charitywater/afridev2-sensor/software/firmware/application/src/waterAlgorithm/algo-c-code/README.md

# algo-c-code

Repository for auto generated C code for water and stroke algorithms. 

Pull down the latest generated C code only after review of the changes and coordination with algorithm developers.
