charitywater/afridev2-sensor/hardware/ME Drawings/Afridev_Mechanical_Package_3-21-18/001_Outpour-afridev3/PCBA, afridev2.sldasm

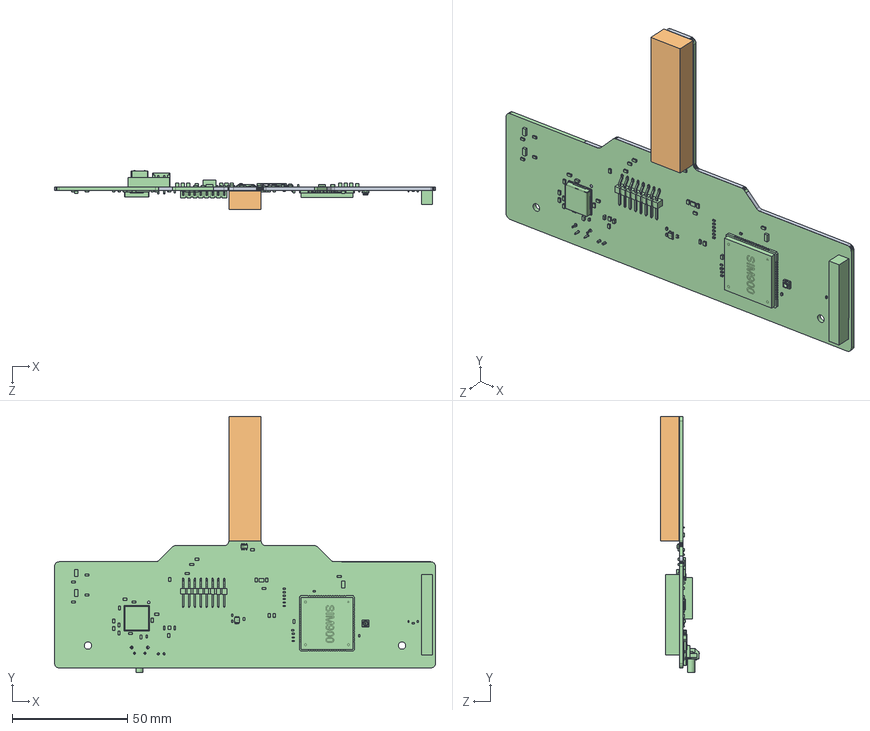
[picture p28: CAD file, 2019-01-26]
hardware/ME Drawings/Afridev_Mechanical_Package_3-21-18/001_Outpour-afridev3/PCBA, afridev2.sldasm
165.0 x 111.1 x 16.7 mm
PCB, afridev2
foam, afridev2 pcba
adhesive, afridev2 pcba
AfriDev_finalPlacement
