charitywater/afridev2-sensor/hardware/ME Drawings/Afridev_Mechanical_Package_3-21-18/001_Outpour-afridev3/01_large_oring.SLDPRT

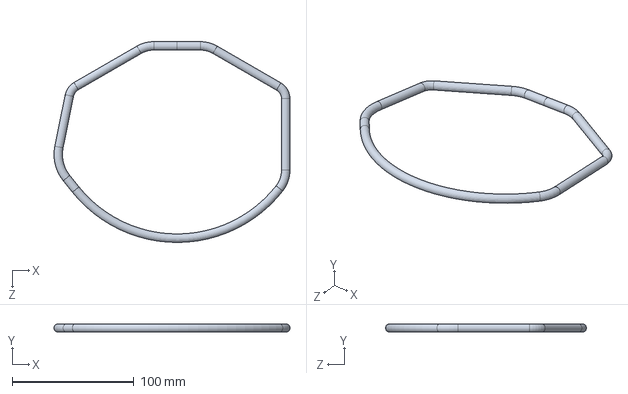
[picture p29: CAD file, 2019-01-26]
hardware/ME Drawings/Afridev_Mechanical_Package_3-21-18/001_Outpour-afridev3/01_large_oring.SLDPRT
194.0 x 6.99 x 165.1 mm
