charitywater/afridev2-sensor/hardware/ME Drawings/Afridev_Mechanical_Package_3-21-18/001_Outpour-afridev3/01_small_oring.SLDPRT

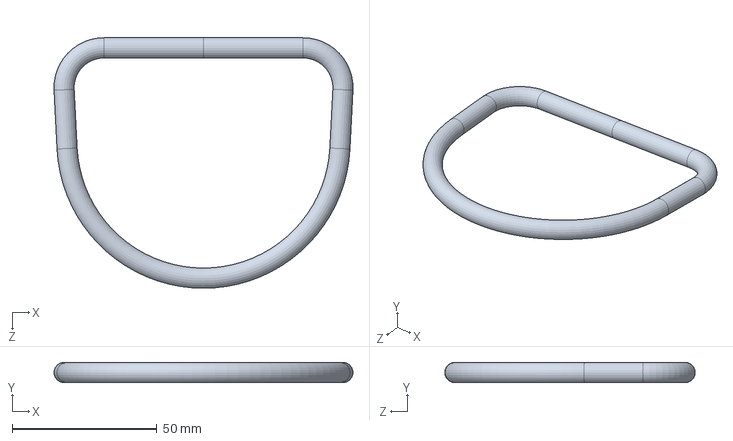
[picture p30: CAD file, 2019-01-26]
hardware/ME Drawings/Afridev_Mechanical_Package_3-21-18/001_Outpour-afridev3/01_small_oring.SLDPRT
103.3 x 6.99 x 86.6 mm
