charitywater/afridev2-sensor/hardware/ME Drawings/Afridev_Mechanical_Package_3-21-18/001_Outpour-afridev3/spacer.SLDPRT

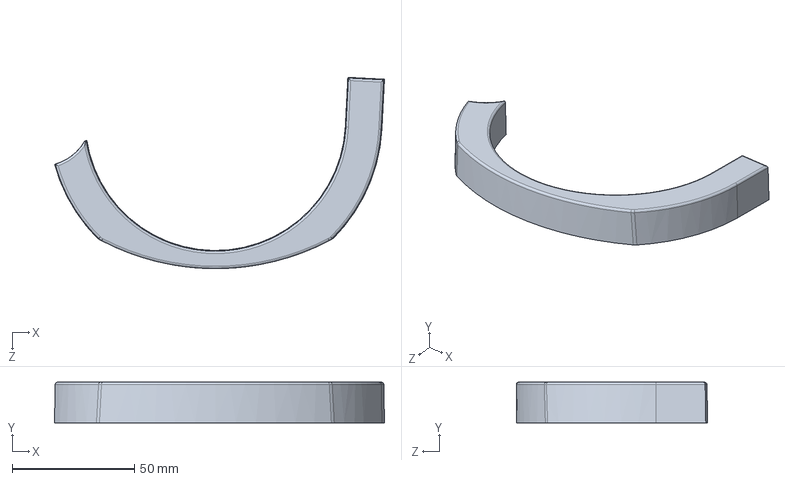
[picture p31: CAD file, 2019-01-26]
hardware/ME Drawings/Afridev_Mechanical_Package_3-21-18/001_Outpour-afridev3/spacer.SLDPRT
134.8 x 16.6 x 78.1 mm
