charitywater/afridev2-sensor/hardware/ME Drawings/Afridev_Mechanical_Package_3-21-18/001_Outpour-afridev3/foam, afridev2 pcba.SLDPRT

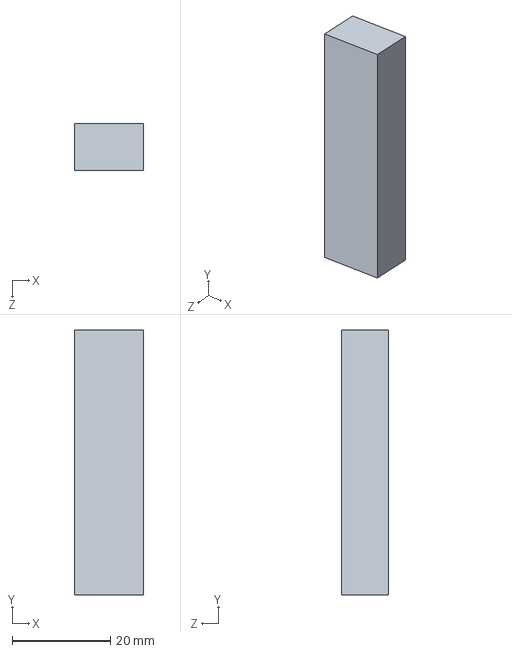
[picture p32: CAD file, 2019-01-26]
hardware/ME Drawings/Afridev_Mechanical_Package_3-21-18/001_Outpour-afridev3/foam, afridev2 pcba.SLDPRT
14.0 x 54.0 x 9.53 mm
