charitywater/afridev2-sensor/hardware/ME Drawings/Afridev_Mechanical_Package_3-21-18/001_Outpour-afridev3/barcode_label.SLDPRT

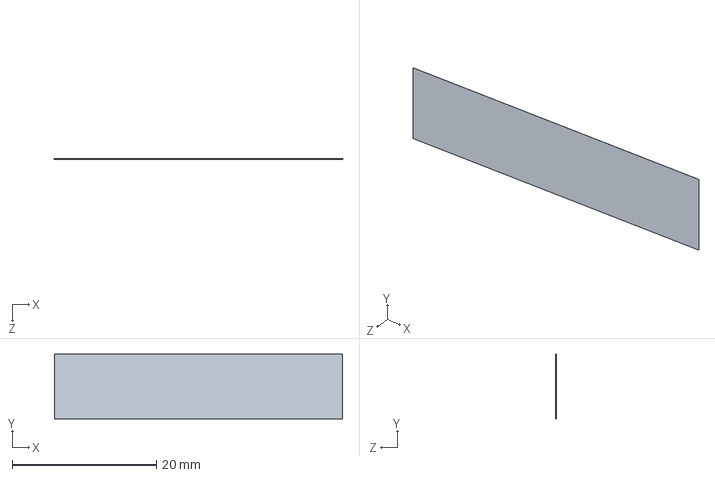
[picture p33: CAD file, 2019-01-26]
hardware/ME Drawings/Afridev_Mechanical_Package_3-21-18/001_Outpour-afridev3/barcode_label.SLDPRT
40.0 x 9.00 x 0.01 mm
