charitywater/afridev2-sensor/hardware/ME Drawings/Afridev_Mechanical_Package_3-21-18/001_Outpour-afridev3/outpour-top-export.sldprt

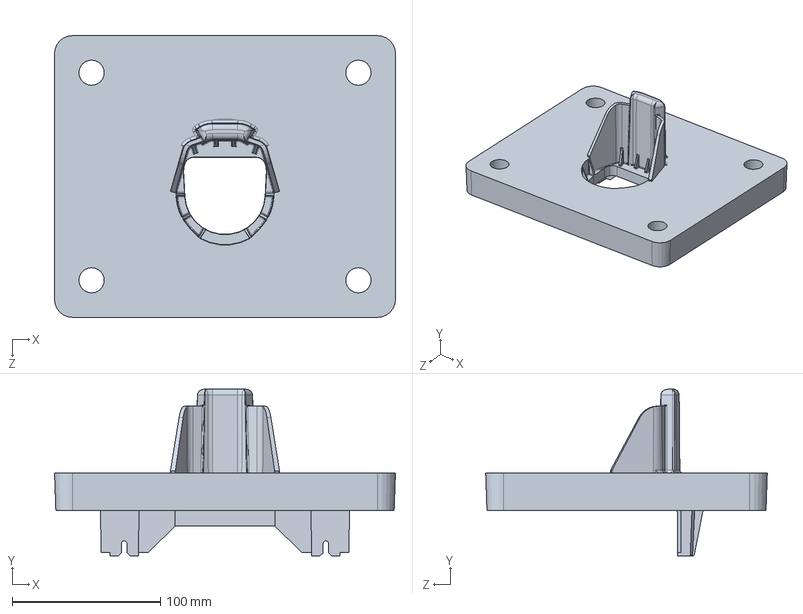
[picture p35: CAD file, 2019-01-26]
hardware/ME Drawings/Afridev_Mechanical_Package_3-21-18/001_Outpour-afridev3/outpour-top-export.sldprt
230.0 x 112.5 x 190.0 mm
