charitywater/afridev2-sensor/hardware/ME Drawings/Afridev_Mechanical_Package_3-21-18/001_Outpour-afridev3/outpour-bottom-export.sldprt

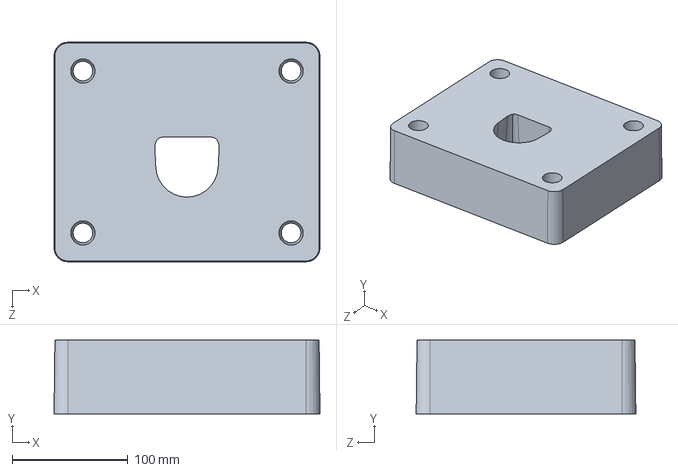
[picture p36: CAD file, 2019-01-26]
hardware/ME Drawings/Afridev_Mechanical_Package_3-21-18/001_Outpour-afridev3/outpour-bottom-export.sldprt
230.0 x 64.0 x 190.0 mm
