charitywater/afridev2-sensor/hardware/ME Drawings/Afridev_Mechanical_Package_3-21-18/001_Outpour-afridev3/01_nutplate_internal.SLDPRT

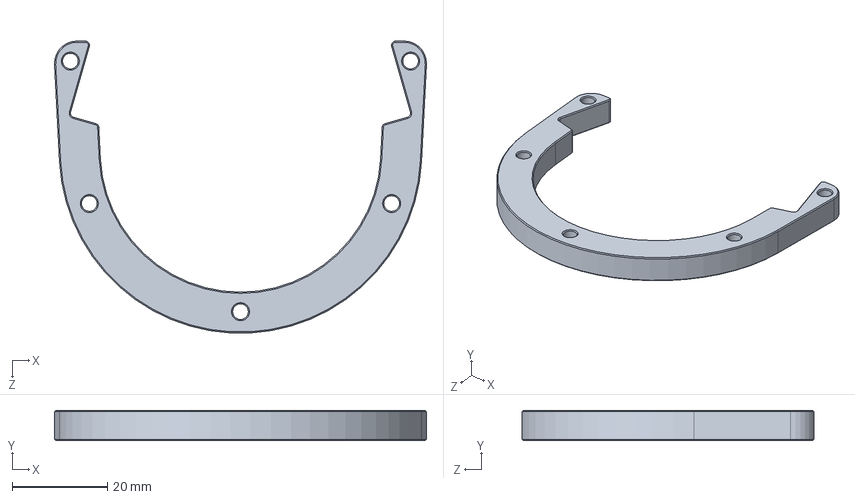
[picture p37: CAD file, 2019-01-26]
hardware/ME Drawings/Afridev_Mechanical_Package_3-21-18/001_Outpour-afridev3/01_nutplate_internal.SLDPRT
78.3 x 6.35 x 61.4 mm
