charitywater/afridev2-sensor/hardware/ME Drawings/Afridev_Mechanical_Package_3-21-18/001_Outpour-afridev3/foam-battery.SLDPRT

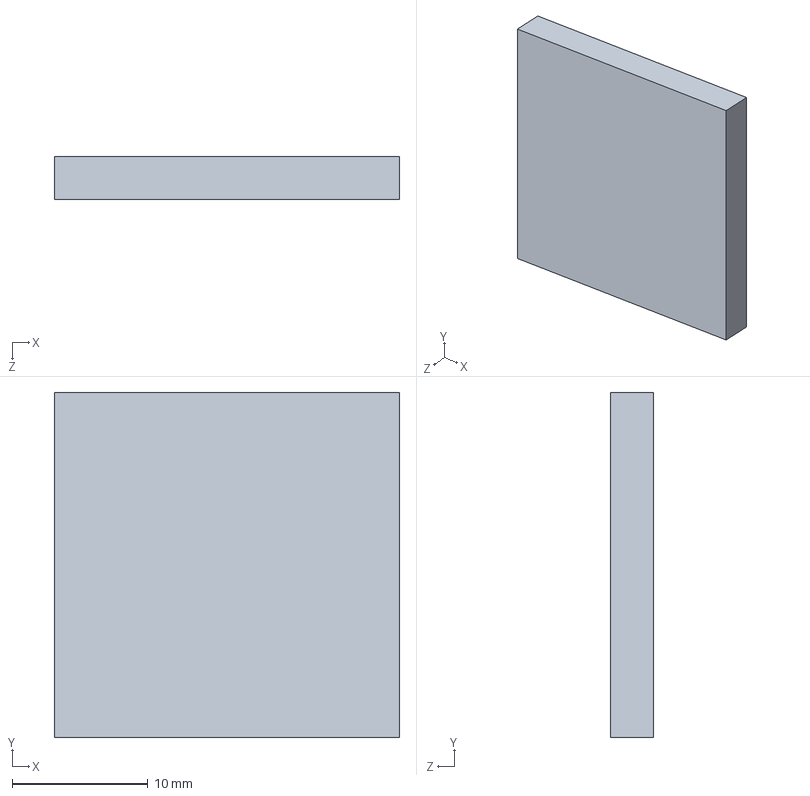
[picture p38: CAD file, 2019-01-26]
hardware/ME Drawings/Afridev_Mechanical_Package_3-21-18/001_Outpour-afridev3/foam-battery.SLDPRT
25.4 x 25.4 x 3.18 mm
