charitywater/afridev2-sensor/hardware/ME Drawings/Afridev_Mechanical_Package_3-21-18/001_Outpour-afridev3/adhesive, afridev2 pcba.SLDPRT

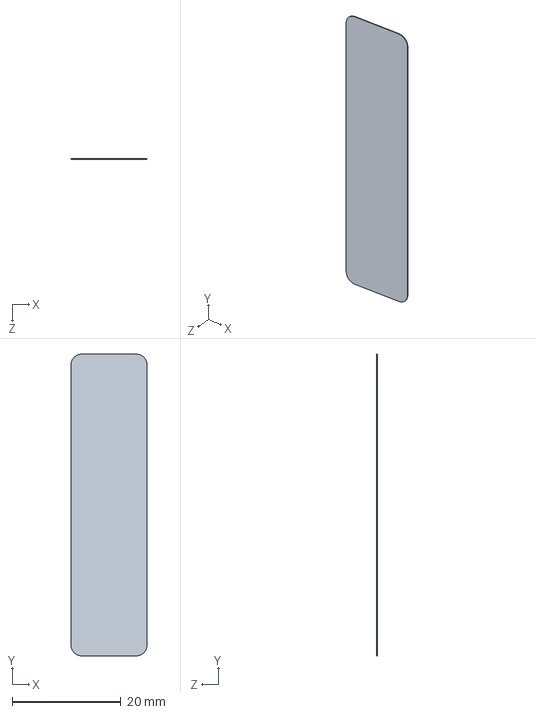
[picture p39: CAD file, 2019-01-26]
hardware/ME Drawings/Afridev_Mechanical_Package_3-21-18/001_Outpour-afridev3/adhesive, afridev2 pcba.SLDPRT
14.0 x 55.5 x 0.127 mm
