charitywater/afridev2-sensor/hardware/ME Drawings/Afridev_Mechanical_Package_3-21-18/001_Outpour-afridev3/PCB, afridev2.SLDPRT

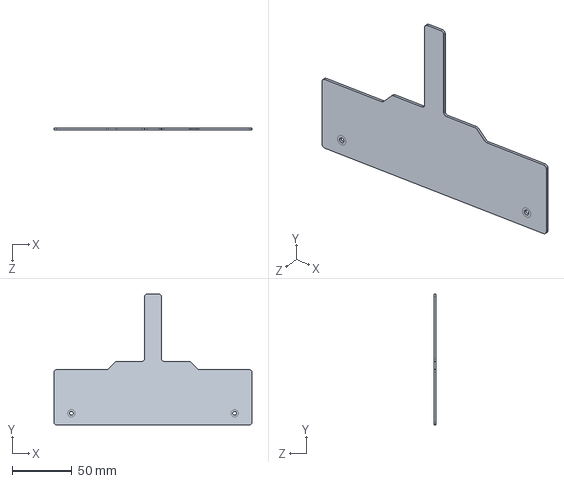
[picture p40: CAD file, 2019-01-26]
hardware/ME Drawings/Afridev_Mechanical_Package_3-21-18/001_Outpour-afridev3/PCB, afridev2.SLDPRT
165.0 x 109.0 x 1.60 mm
