charitywater/afridev2-sensor/hardware/ME Drawings/Afridev_Mechanical_Package_3-21-18/001_Outpour-afridev3/01_hsg_bottom.SLDPRT

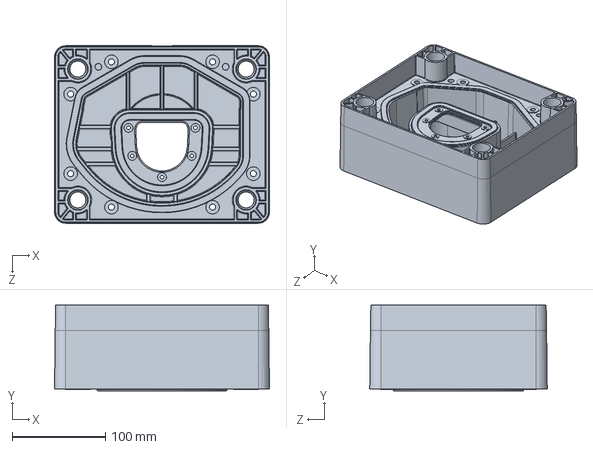
[picture p41: CAD file, 2019-01-26]
hardware/ME Drawings/Afridev_Mechanical_Package_3-21-18/001_Outpour-afridev3/01_hsg_bottom.SLDPRT
230.0 x 91.8 x 190.0 mm
