charitywater/afridev2-sensor/hardware/ME Drawings/Afridev_Mechanical_Package_3-21-18/001_Outpour-afridev3/91287A204_18-8 STAINLESS STEEL HEX HEAD CAP SCREW.SLDPRT

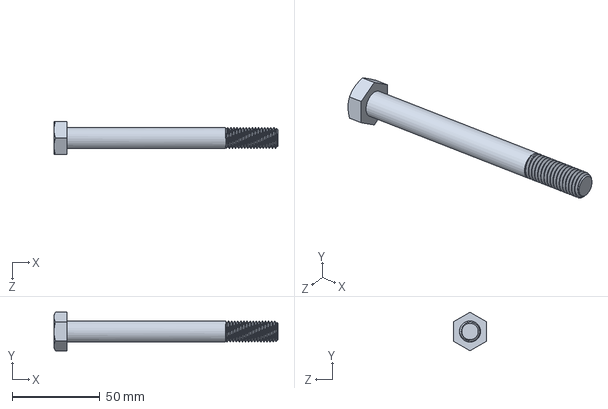
[picture p42: CAD file, 2019-01-26]
hardware/ME Drawings/Afridev_Mechanical_Package_3-21-18/001_Outpour-afridev3/91287A204_18-8 STAINLESS STEEL HEX HEAD CAP SCREW.SLDPRT
127.5 x 21.9 x 19.0 mm
