charitywater/afridev2-sensor/hardware/ME Drawings/Afridev_Mechanical_Package_3-21-18/001_Outpour-afridev3/90965A170_TYPE 316 STAINLESS STEEL FLAT WASHER.SLDPRT

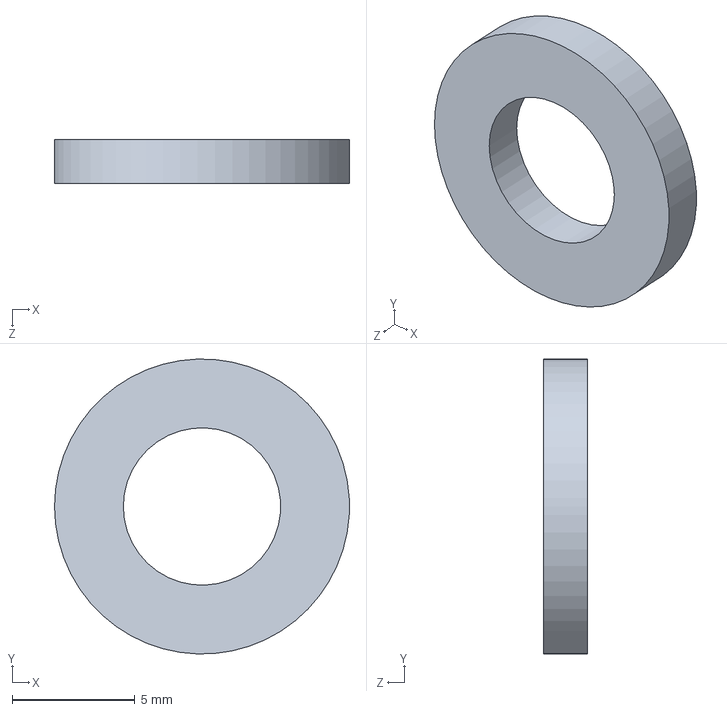
[picture p43: CAD file, 2019-01-26]
hardware/ME Drawings/Afridev_Mechanical_Package_3-21-18/001_Outpour-afridev3/90965A170_TYPE 316 STAINLESS STEEL FLAT WASHER.SLDPRT
12.0 x 12.0 x 1.80 mm
