charitywater/afridev2-sensor/(list of files, cad)

Other CAD files:
hardware/ME Drawings/Afridev_Mechanical_Package_3-21-18/001_Outpour-afridev3/Outpour-Cell-93111.sldprt
hardware/ME Drawings/Afridev_Mechanical_Package_3-21-18/001_Outpour-afridev3/outpour-afridev-outer-o-ring.sldprt
hardware/ME Drawings/Afridev_Mechanical_Package_3-21-18/001_Outpour-afridev3/01_hsg_bottom.SLDDRW
hardware/ME Drawings/Afridev_Mechanical_Package_3-21-18/001_Outpour-afridev3/01_hsg_top.SLDDRW
hardware/ME Drawings/Afridev_Mechanical_Package_3-21-18/001_Outpour-afridev3/01_nutplate_internal.SLDDRW
hardware/ME Drawings/Afridev_Mechanical_Package_3-21-18/001_Outpour-afridev3/90116A155.SLDPRT
hardware/ME Drawings/Afridev_Mechanical_Package_3-21-18/001_Outpour-afridev3/90116A213_METRIC 316 SS PAN HEAD PHILLIPS MACHINE SCREW.SLDPRT
hardware/ME Drawings/Afridev_Mechanical_Package_3-21-18/001_Outpour-afridev3/90116A317_METRIC 316 SS PAN HEAD PHILLIPS MACHINE SCREW.SLDPRT
hardware/ME Drawings/Afridev_Mechanical_Package_3-21-18/001_Outpour-afridev3/92773A104_TYPE 316 SS SERRATED-FLANGE LOCKNUT.SLDPRT
hardware/ME Drawings/Afridev_Mechanical_Package_3-21-18/001_Outpour-afridev3/94205A220_TYPE 316 STAINLESS STEEL NYLON-INSERT LOCKNUT.SLDPRT
hardware/ME Drawings/Afridev_Mechanical_Package_3-21-18/001_Outpour-afridev3/94205A250_TYPE 316 STAINLESS STEEL NYLON-INSERT LOCKNUT.SLDPRT
hardware/ME Drawings/Afridev_Mechanical_Package_3-21-18/001_Outpour-afridev3/Outpour-Cell-93111.SLDDRW
hardware/ME Drawings/Afridev_Mechanical_Package_3-21-18/001_Outpour-afridev3/foam, afridev2 pcba.SLDDRW
hardware/ME Drawings/Afridev_Mechanical_Package_3-21-18/001_Outpour-afridev3/foam-battery.SLDDRW
