charitywater/afridev2-sensor/hardware/ME Drawings/Afridev_Mechanical_Package_3-21-18/01_hsg_bottom-rev3.PDF

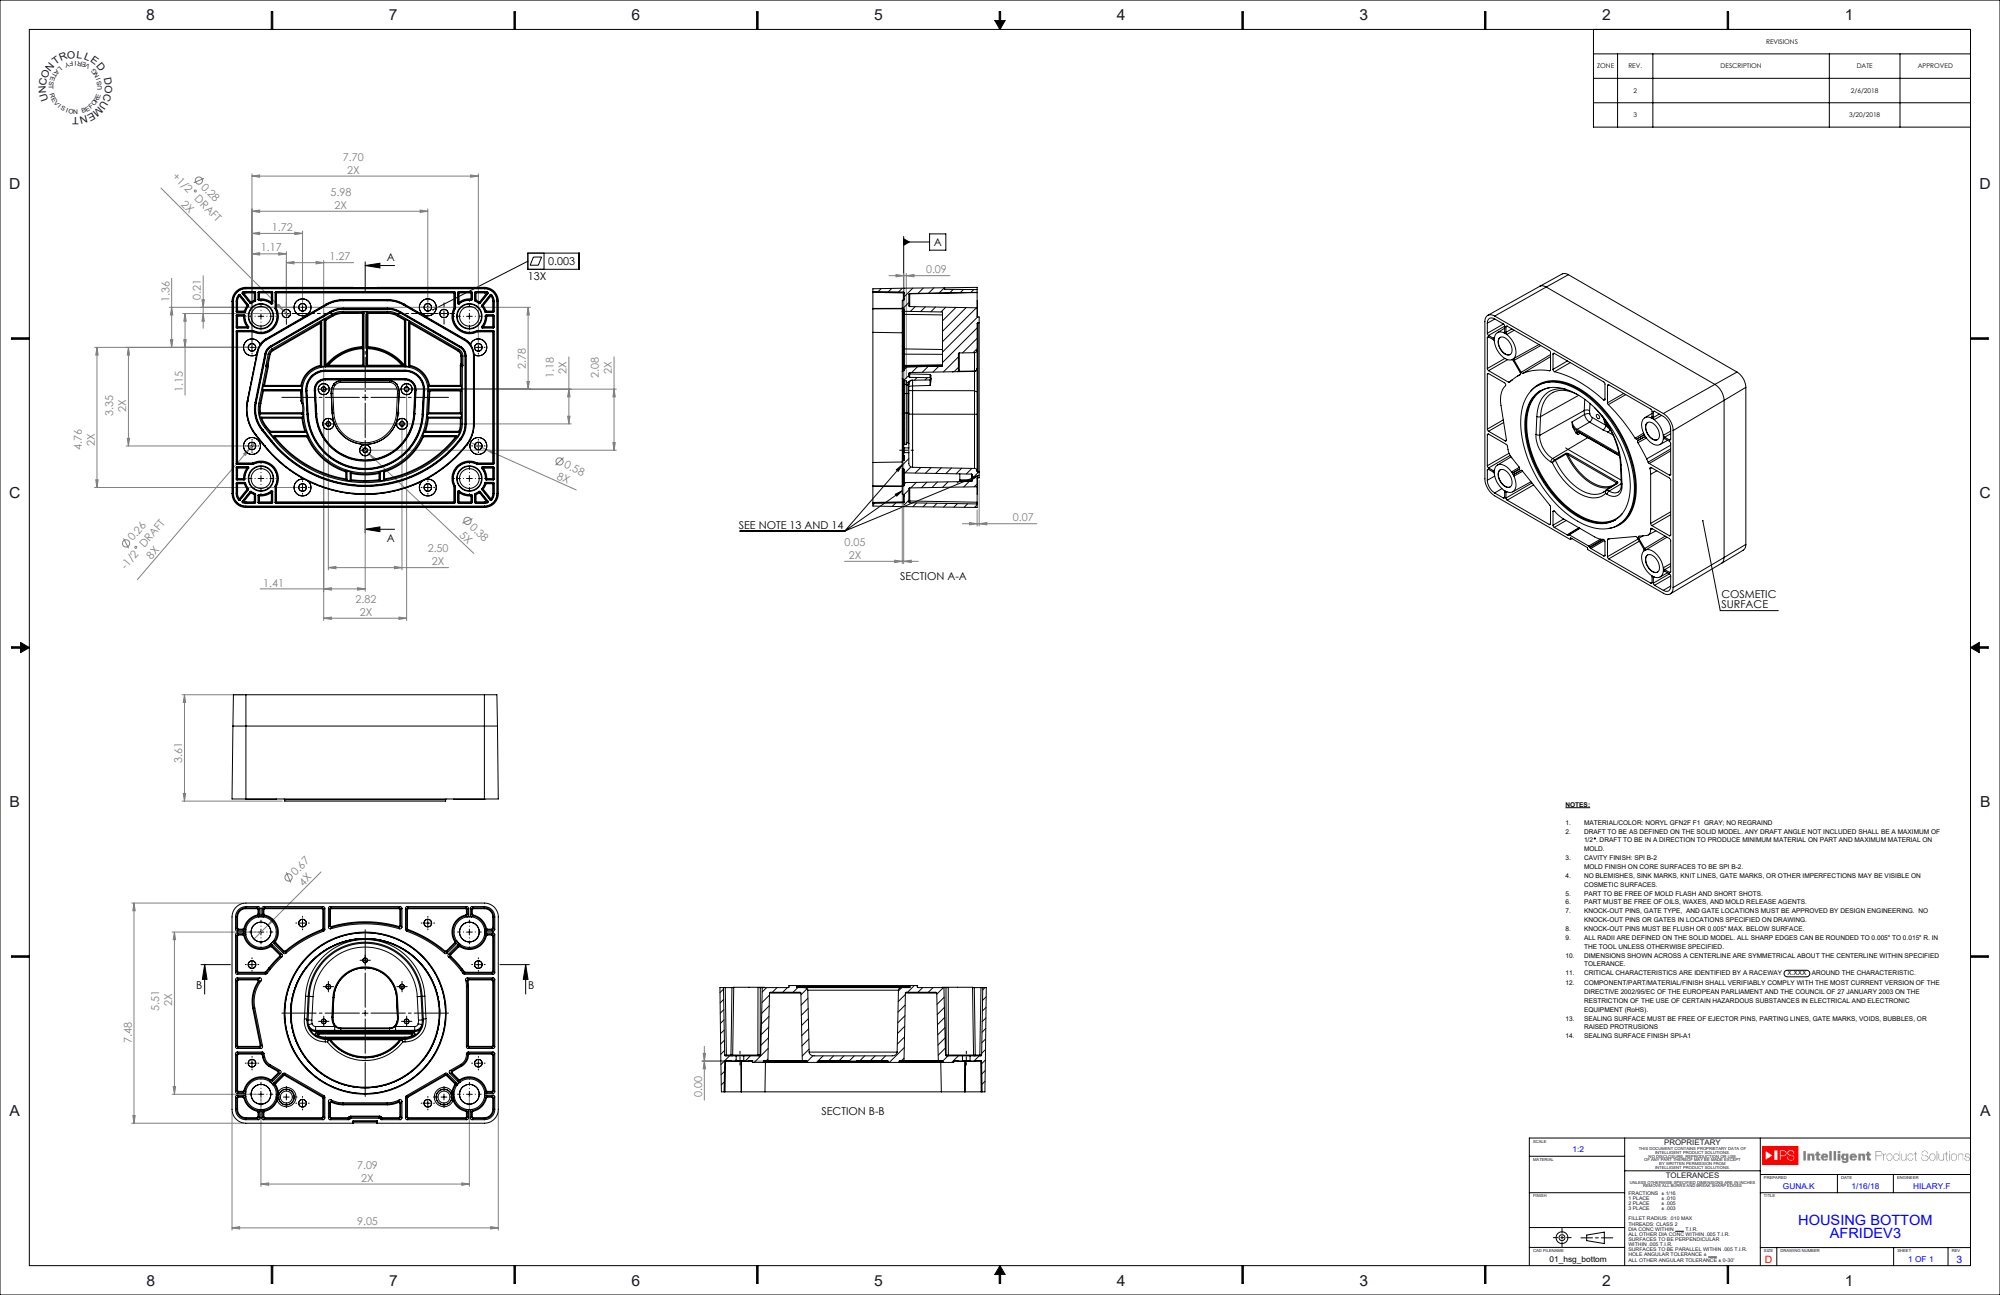
[picture p97: page 1]
+1/2 DRAFT 2X; 0.26 -1/2 DRAFT 8X; SECTION A-A; SECTION B-B; 11. CRITICAL CHARACTERISTICS ARE IDENTIFIED BY A RACEWAY; X.XXX; AROUND THE CHARACTERISTIC.; ZONE; REV.; DESCRIPTION; DATE; APPROVED 2; SIZE D; DRAWING NUMBER; 1 PLACE; 2 PLACE; 3 PLACE; DIA CONC WITHIN; CAD FILENAME; HOUSING BOTTOM

BEFORE US I NG V RE NEMUCOD D LE

SEE NOTE 13 AND 14

1. MATERIAL/COLOR: NORYL GFN2F F1 GRAY; NO REGRAIND
2. DRAFT TO BE AS DEFINED ON THE SOLID MODEL. ANY DRAFT ANGLE NOT INCLUDED SHALL BE A MAXIMUM OF
1/2 . DRAFT TO BE IN A DIRECTION TO PRODUCE MINIMUM MATERIAL ON PART AND MAXIMUM MATERIAL ON
MOLD.
3. CAVITY FINISH: SPI B-2
MOLD FINISH ON CORE SURFACES TO BE SPI B-2.
4. NO BLEMISHES, SINK MARKS, KNIT LINES, GATE MARKS, OR OTHER IMPERFECTIONS MAY BE VISIBLE ON
COSMETIC SURFACES.
5. PART TO BE FREE OF MOLD FLASH AND SHORT SHOTS.
6. PART MUST BE FREE OF OILS, WAXES, AND MOLD RELEASE AGENTS.
7. KNOCK-OUT PINS, GATE TYPE, AND GATE LOCATIONS MUST BE APPROVED BY DESIGN ENGINEERING. NO
KNOCK-OUT PINS OR GATES IN LOCATIONS SPECIFIED ON DRAWING.
8. KNOCK-OUT PINS MUST BE FLUSH OR 0.005" MAX. BELOW SURFACE.
9. ALL RADII ARE DEFINED ON THE SOLID MODEL. ALL SHARP EDGES CAN BE ROUNDED TO 0.005" TO 0.015" R. IN
THE TOOL UNLESS OTHERWISE SPECIFIED.
10. DIMENSIONS SHOWN ACROSS A CENTERLINE ARE SYMMETRICAL ABOUT THE CENTERLINE WITHIN SPECIFIED
TOLERANCE.
12. COMPONENT/PART/MATERIAL/FINISH SHALL VERIFIABLY COMPLY WITH THE MOST CURRENT VERSION OF THE
DIRECTIVE 2002/95/EC OF THE EUROPEAN PARLIAMENT AND THE COUNCIL OF 27 JANUARY 2003 ON THE
RESTRICTION OF THE USE OF CERTAIN HAZARDOUS SUBSTANCES IN ELECTRICAL AND ELECTRONIC
EQUIPMENT (RoHS).
13. SEALING SURFACE MUST BE FREE OF EJECTOR PINS, PARTING LINES, GATE MARKS, VOIDS, BUBBLES, OR
RAISED PROTRUSIONS
14. SEALING SURFACE FINISH SPI-A1

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
