charitywater/afridev2-sensor/hardware/ME Drawings/Afridev_Mechanical_Package_3-21-18/01_nutplate_internal-R1.PDF

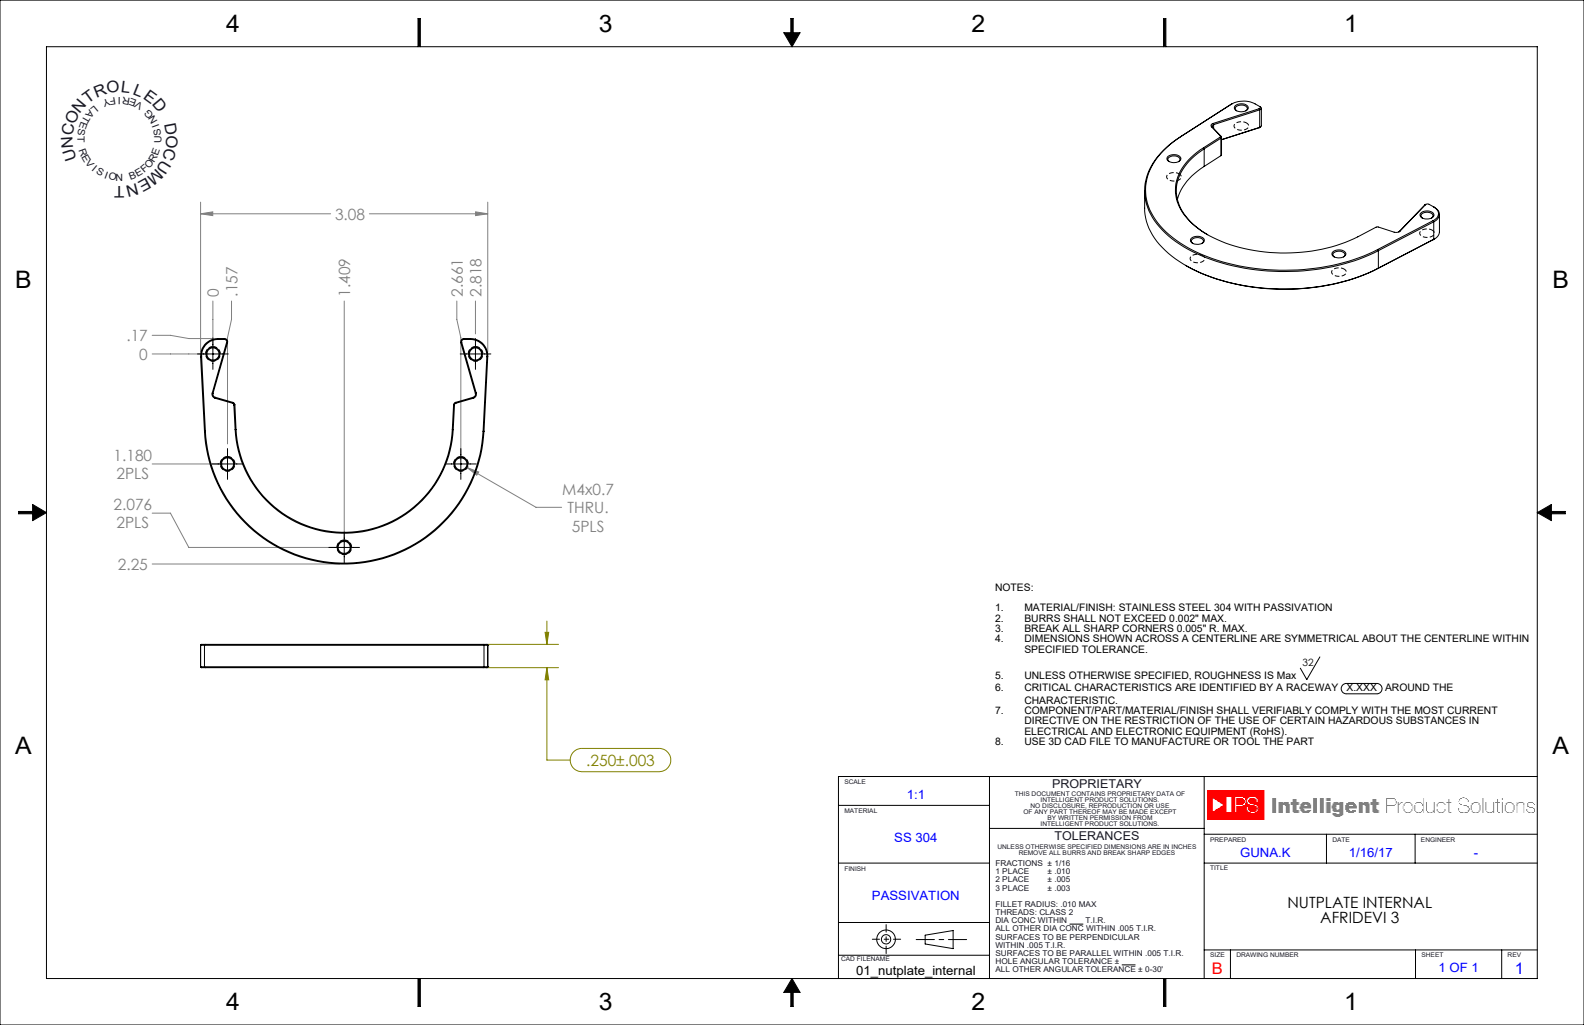
[picture p98: page 1]
CRITICAL CHARACTERISTICS ARE IDENTIFIED BY A RACEWAY; X.XXX; AROUND THE; DRAWING NUMBER; 1 PLACE; 2 PLACE; 3 PLACE; DIA CONC WITHIN; CAD FILENAME; UNLESS OTHERWISE SPECIFIED DIMENSIONS ARE IN INCHES REMOVE ALL BURRS AND BREAK SHARP EDGES; GUNA.K; CONTROL LED; OCUM NE EROF BE; I S VER; SETAL YFI; NUTPLATE INTERNAL AFRIDEVI 3

NOTES:
1. MATERIAL/FINISH: STAINLESS STEEL 304 WITH PASSIVATION
2. BURRS SHALL NOT EXCEED 0.002" MAX.
3. BREAK ALL SHARP CORNERS 0.005" R. MAX.
4. DIMENSIONS SHOWN ACROSS A CENTERLINE ARE SYMMETRICAL ABOUT THE CENTERLINE WITHIN
SPECIFIED TOLERANCE.
UNLESS OTHERWISE SPECIFIED, ROUGHNESS IS Max
CHARACTERISTIC.
7. COMPONENT/PART/MATERIAL/FINISH SHALL VERIFIABLY COMPLY WITH THE MOST CURRENT
DIRECTIVE ON THE RESTRICTION OF THE USE OF CERTAIN HAZARDOUS SUBSTANCES IN
ELECTRICAL AND ELECTRONIC EQUIPMENT (RoHS).
8. USE 3D CAD FILE TO MANUFACTURE OR TOOL THE PART

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
