charitywater/afridev2-sensor/hardware/ME Drawings/Afridev_Mechanical_Package_3-21-18/foam, afridev2 pcba-REV2.PDF

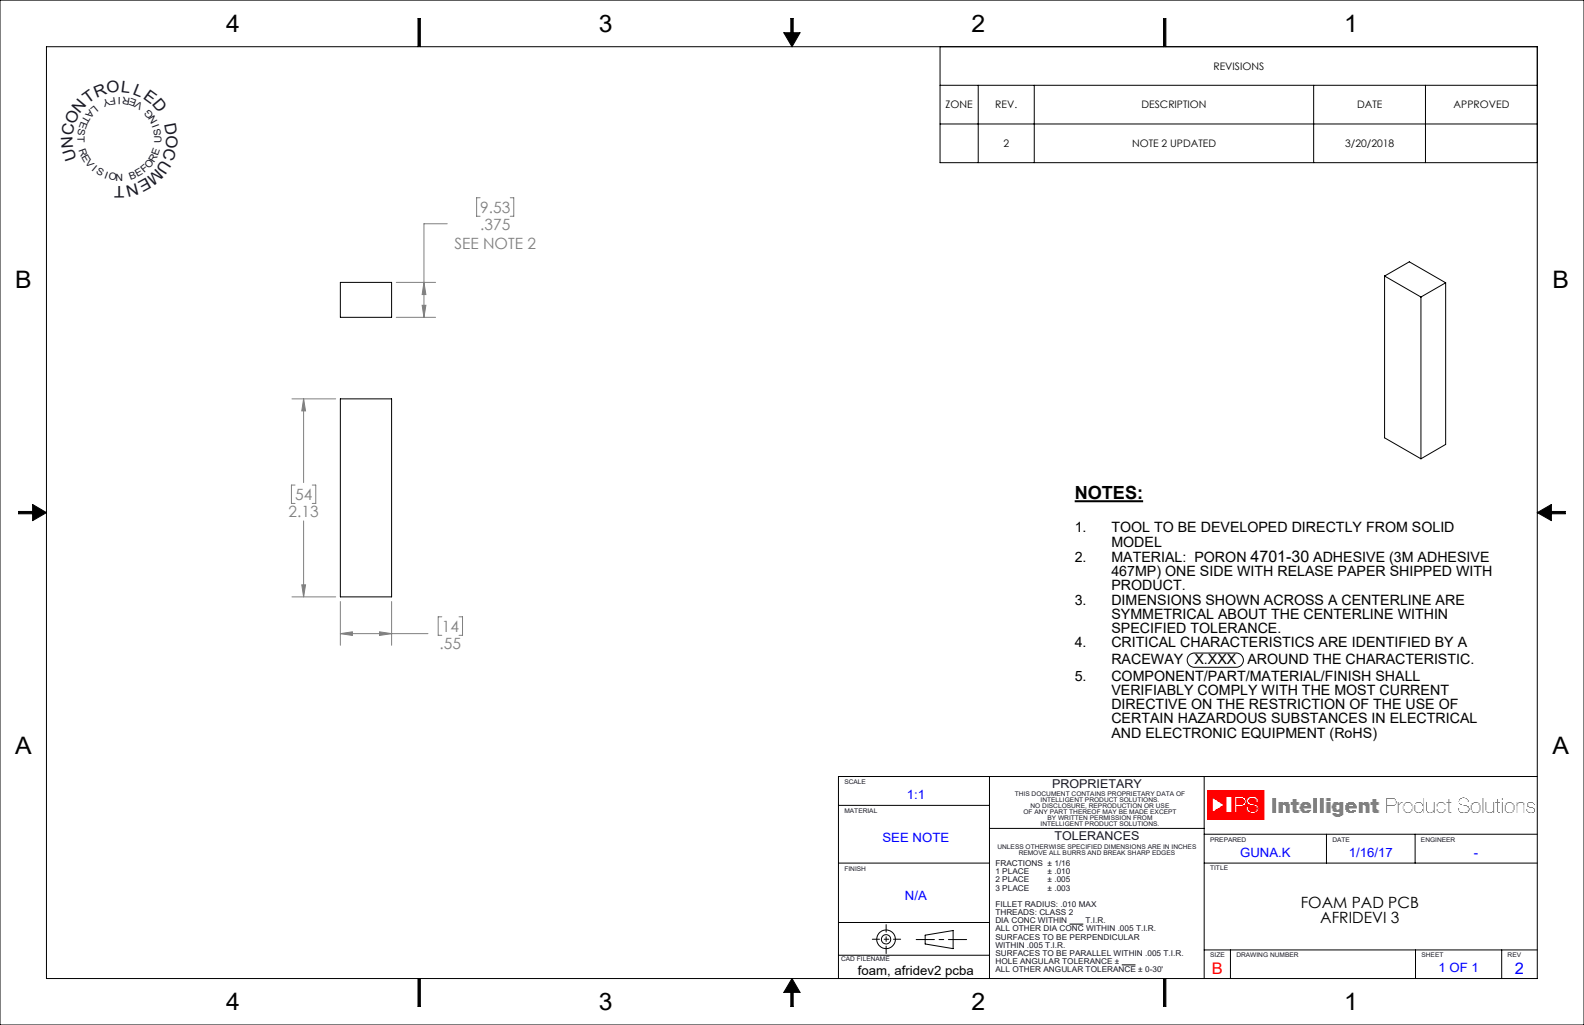
[picture p99: page 1]
SEE NOTE 2; RACEWAY; X.XXX; AROUND THE CHARACTERISTIC.; DRAWING NUMBER; 1 PLACE; 2 PLACE; 3 PLACE; DIA CONC WITHIN; CAD FILENAME; UNLESS OTHERWISE SPECIFIED DIMENSIONS ARE IN INCHES REMOVE ALL BURRS AND BREAK SHARP EDGES; GUNA.K; SEE NOTE; foam, afridev2 pcba; CONTROL LED; OCUM NE EROF BE; I S VER; SETAL YFI

ZONE | REV. | DESCRIPTION | DATE | APPROVED

2 | NOTE 2 UPDATED | 3/20/2018

1. TOOL TO BE DEVELOPED DIRECTLY FROM SOLID
MODEL
2. MATERIAL: PORON 4701-30 ADHESIVE (3M ADHESIVE
467MP) ONE SIDE WITH RELASE PAPER SHIPPED WITH
PRODUCT.
3. DIMENSIONS SHOWN ACROSS A CENTERLINE ARE
SYMMETRICAL ABOUT THE CENTERLINE WITHIN
SPECIFIED TOLERANCE.
4. CRITICAL CHARACTERISTICS ARE IDENTIFIED BY A
5. COMPONENT/PART/MATERIAL/FINISH SHALL
VERIFIABLY COMPLY WITH THE MOST CURRENT
DIRECTIVE ON THE RESTRICTION OF THE USE OF
CERTAIN HAZARDOUS SUBSTANCES IN ELECTRICAL
AND ELECTRONIC EQUIPMENT (RoHS)

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

FOAM PAD PCB
AFRIDEVI 3
