charitywater/afridev2-sensor/hardware/ME Drawings/PDF DRAWING CHARITY WATER REV-1/001_Outpour-afridev3-R1.PDF

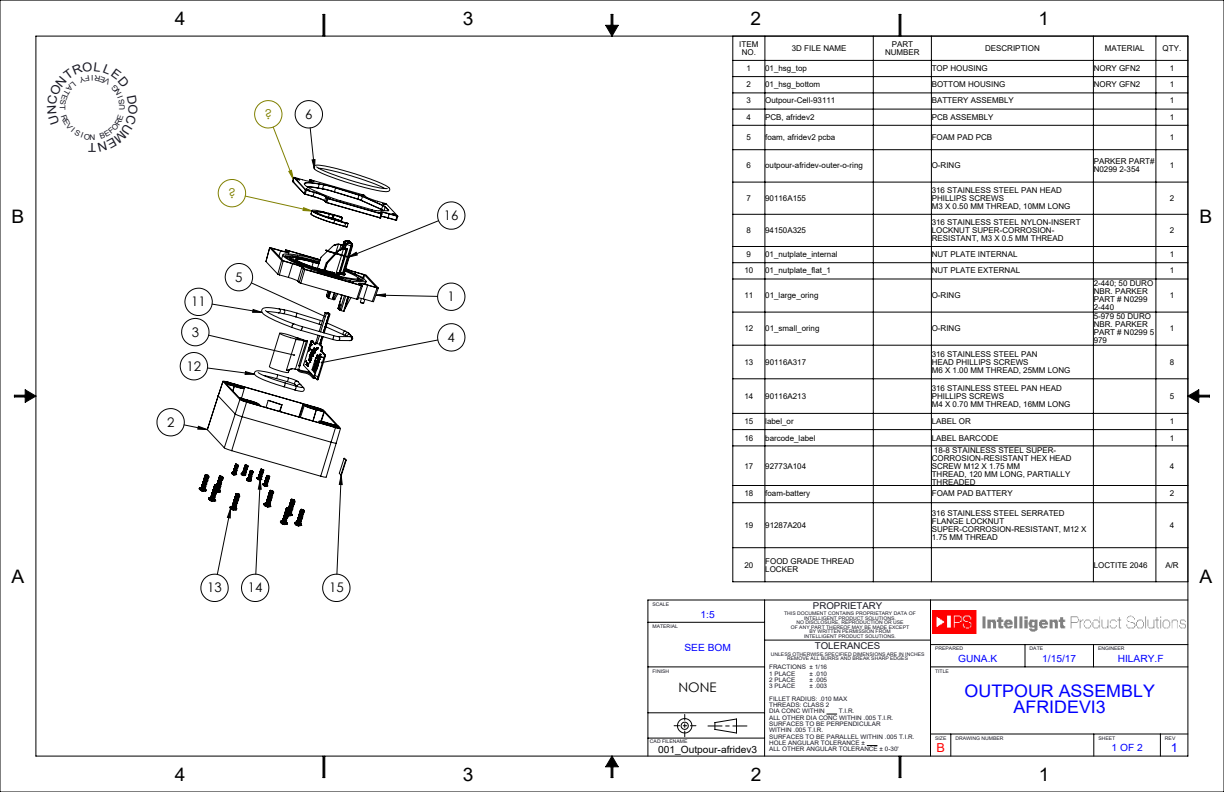
[picture p100: page 1]
SIZE B; DRAWING NUMBER; 1 PLACE; 2 PLACE; 3 PLACE; DIA CONC WITHIN; CAD FILENAME; OUTPOUR ASSEMBLY; SEE BOM

ITEM NO. | 3D FILE NAME | PART NUMBER | DESCRIPTION | MATERIAL | QTY.

LED DOCUM NE REV GNI SU EROF BE

1 | 01_hsg_top | | TOP HOUSING | NORY GFN2 | 1
2 | 01_hsg_bottom | | BOTTOM HOUSING | NORY GFN2 | 1
3 | Outpour-Cell-93111 | | BATTERY ASSEMBLY | | 1
4 | PCB, afridev2 | | PCB ASSEMBLY | | 1
5 | foam, afridev2 pcba | | FOAM PAD PCB | | 1

I S VER TSETAL YF

6 | outpour-afridev-outer-o-ring | | O-RING | PARKER PART# N0299 2-354 | 1

7 | 90116A155 | | 316 STAINLESS STEEL PAN HEAD PHILLIPS SCREWS M3 X 0.50 MM THREAD, 10MM LONG | | 2

8 | 94150A325 | | 316 STAINLESS STEEL NYLON-INSERT LOCKNUT SUPER-CORROSION-RESISTANT, M3 X 0.5 MM THREAD | | 2

9 | 01_nutplate_internal | | NUT PLATE INTERNAL | | 1
10 | 01_nutplate_flat_1 | | NUT PLATE EXTERNAL | | 1
11 | 01_large_oring | | O-RING | 2-440; 50 DURO NBR. PARKER PART # N0299 2-440 | 1

12 | 01_small_oring | | O-RING | 5-979 50 DURO NBR. PARKER PART # N0299 5 979 | 1

13 | 90116A317 | | 316 STAINLESS STEEL PAN HEAD PHILLIPS SCREWS M6 X 1.00 MM THREAD, 25MM LONG | | 8

14 | 90116A213 | | 316 STAINLESS STEEL PAN HEAD PHILLIPS SCREWS M4 X 0.70 MM THREAD, 16MM LONG | | 5

15 | label_or | | LABEL OR | | 1
16 | barcode_label | | LABEL BARCODE | | 1
17 | 92773A104 | | 18-8 STAINLESS STEEL SUPER-CORROSION-RESISTANT HEX HEAD SCREW M12 X 1.75 MM THREAD, 120 MM LONG, PARTIALLY THREADED | | 4

18 | foam-battery | | FOAM PAD BATTERY | | 2
19 | 91287A204 | | 316 STAINLESS STEEL SERRATED FLANGE LOCKNUT SUPER-CORROSION-RESISTANT, M12 X 1.75 MM THREAD | | 4

20 | FOOD GRADE THREAD LOCKER | | | LOCTITE 2046 | A/R

PROPRIETARY THIS DOCUMENT CONTAINS PROPRIETARY DATA OF INTELLIGENT PRODUCT SOLUTIONS. NO DISCLOSURE, REPRODUCTION OR USE OF ANY PART THEREOF MAY BE MADE EXCEPT BY WRITTEN PERMISSION FROM INTELLIGENT PRODUCT SOLUTIONS.

UNLESS OTHERWISE SPECIFIED DIMENSIONS ARE IN INCHES REMOVE ALL BURRS AND BREAK SHARP EDGES
FRACTIONS ± 1/16
FILLET RADIUS: .010 MAX
THREADS: CLASS 2
ALL OTHER DIA CONC WITHIN .005 T.I.R.
SURFACES TO BE PERPENDICULAR
WITHIN .005 T.I.R.
SURFACES TO BE PARALLEL WITHIN .005 T.I.R.
HOLE ANGULAR TOLERANCE ±
ALL OTHER ANGULAR TOLERANCE ± 0-30'

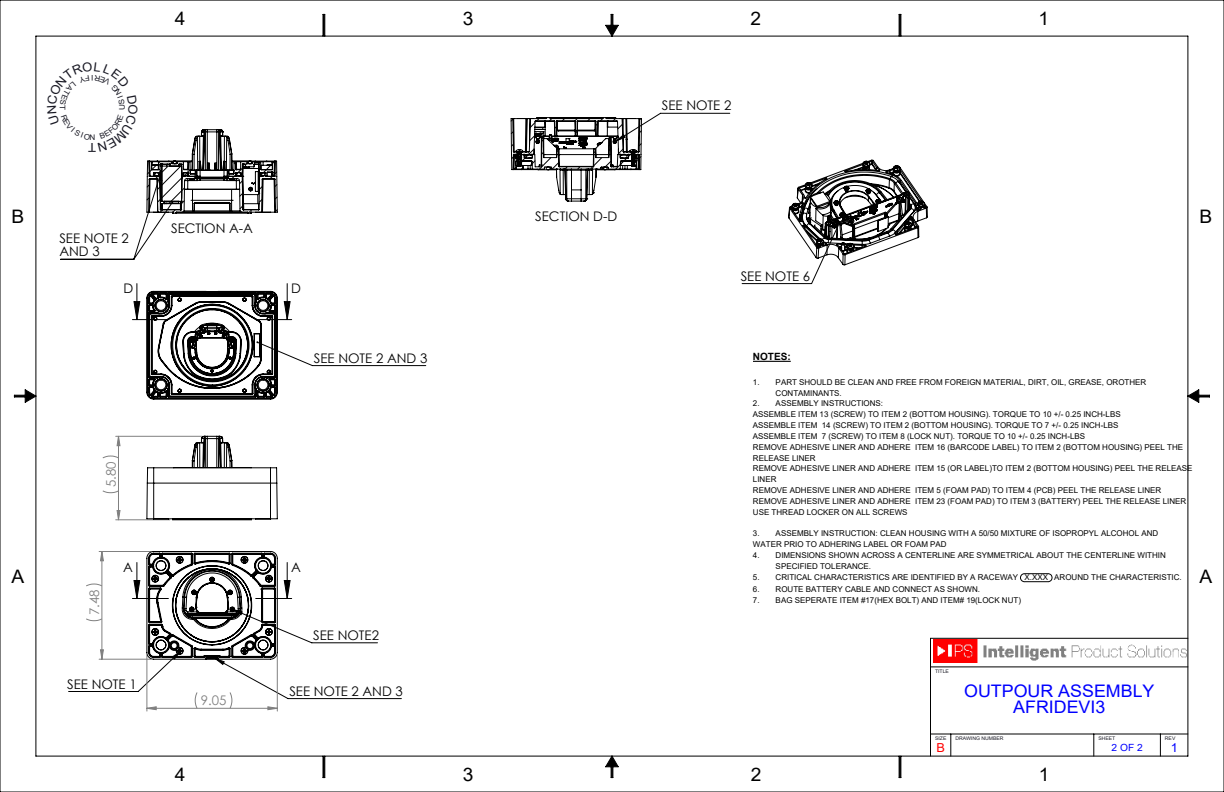
[picture p101: page 2]
SEE NOTE 1; SEE NOTE2; SECTION A-A; SEE NOTE 2 AND 3; SECTION D-D; SEE NOTE 2; SEE NOTE 6; CRITICAL CHARACTERISTICS ARE IDENTIFIED BY A RACEWAY; X.XXX; AROUND THE CHARACTERISTIC.; DRAWING NUMBER; OUTPOUR ASSEMBLY; CONTROL LED; OCUM NE EROF BE; I S VER; SETAL YFI

SEE NOTE 2 AND 3

1. PART SHOULD BE CLEAN AND FREE FROM FOREIGN MATERIAL, DIRT, OIL, GREASE, OROTHER
CONTAMINANTS.
2. ASSEMBLY INSTRUCTIONS:
ASSEMBLE ITEM 13 (SCREW) TO ITEM 2 (BOTTOM HOUSING). TORQUE TO 10 +/- 0.25 INCH-LBS
ASSEMBLE ITEM 14 (SCREW) TO ITEM 2 (BOTTOM HOUSING). TORQUE TO 7 +/- 0.25 INCH-LBS
ASSEMBLE ITEM 7 (SCREW) TO ITEM 8 (LOCK NUT). TORQUE TO 10 +/- 0.25 INCH-LBS
REMOVE ADHESIVE LINER AND ADHERE ITEM 16 (BARCODE LABEL) TO ITEM 2 (BOTTOM HOUSING) PEEL THE
RELEASE LINER
REMOVE ADHESIVE LINER AND ADHERE ITEM 15 (OR LABEL)TO ITEM 2 (BOTTOM HOUSING) PEEL THE RELEASE
LINER
REMOVE ADHESIVE LINER AND ADHERE ITEM 5 (FOAM PAD) TO ITEM 4 (PCB) PEEL THE RELEASE LINER
REMOVE ADHESIVE LINER AND ADHERE ITEM 23 (FOAM PAD) TO ITEM 3 (BATTERY) PEEL THE RELEASE LINER
USE THREAD LOCKER ON ALL SCREWS

3. ASSEMBLY INSTRUCTION: CLEAN HOUSING WITH A 50/50 MIXTURE OF ISOPROPYL ALCOHOL AND
WATER PRIO TO ADHERING LABEL OR FOAM PAD
4. DIMENSIONS SHOWN ACROSS A CENTERLINE ARE SYMMETRICAL ABOUT THE CENTERLINE WITHIN
SPECIFIED TOLERANCE.
6. ROUTE BATTERY CABLE AND CONNECT AS SHOWN.
7. BAG SEPERATE ITEM #17(HEX BOLT) AND ITEM# 19(LOCK NUT)
