charitywater/afridev2-sensor/hardware/ME Drawings/PDF DRAWING CHARITY WATER REV-1/Outpour-Cell-93111-R1.PDF

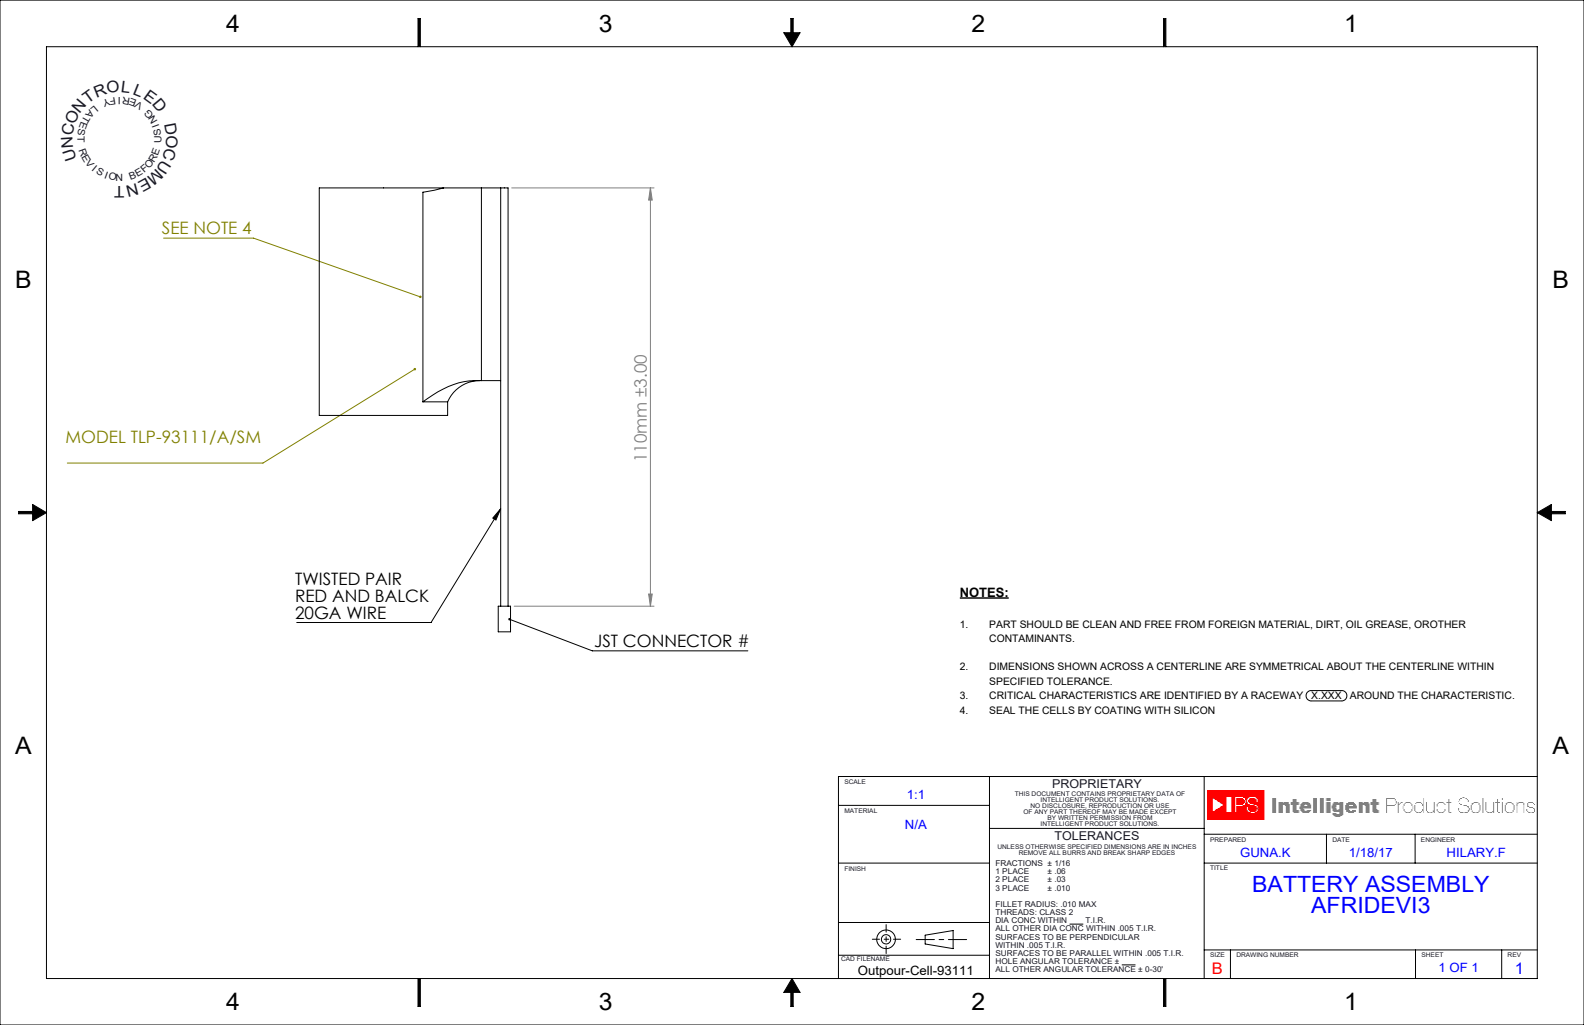
[picture p102: page 1]
JST CONNECTOR #; SEE NOTE 4; CRITICAL CHARACTERISTICS ARE IDENTIFIED BY A RACEWAY; X.XXX; AROUND THE CHARACTERISTIC.; DRAWING NUMBER; 1 PLACE; 2 PLACE; 3 PLACE; DIA CONC WITHIN; CAD FILENAME; BATTERY ASSEMBLY; CONTROL LED; OCUM NE EROF BE; I S VER; SETAL YFI

MODEL TLP-93111/A/SM

TWISTED PAIR
RED AND BALCK
20GA WIRE

1. PART SHOULD BE CLEAN AND FREE FROM FOREIGN MATERIAL, DIRT, OIL GREASE, OROTHER
CONTAMINANTS.

2. DIMENSIONS SHOWN ACROSS A CENTERLINE ARE SYMMETRICAL ABOUT THE CENTERLINE WITHIN
SPECIFIED TOLERANCE.
4. SEAL THE CELLS BY COATING WITH SILICON

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
