charitywater/afridev2-sensor/hardware/EE Drawings/Afridev_rev2_ProductionFiles_013018/Schematics/AfriDev_Rev2.0_Schematics.PDF

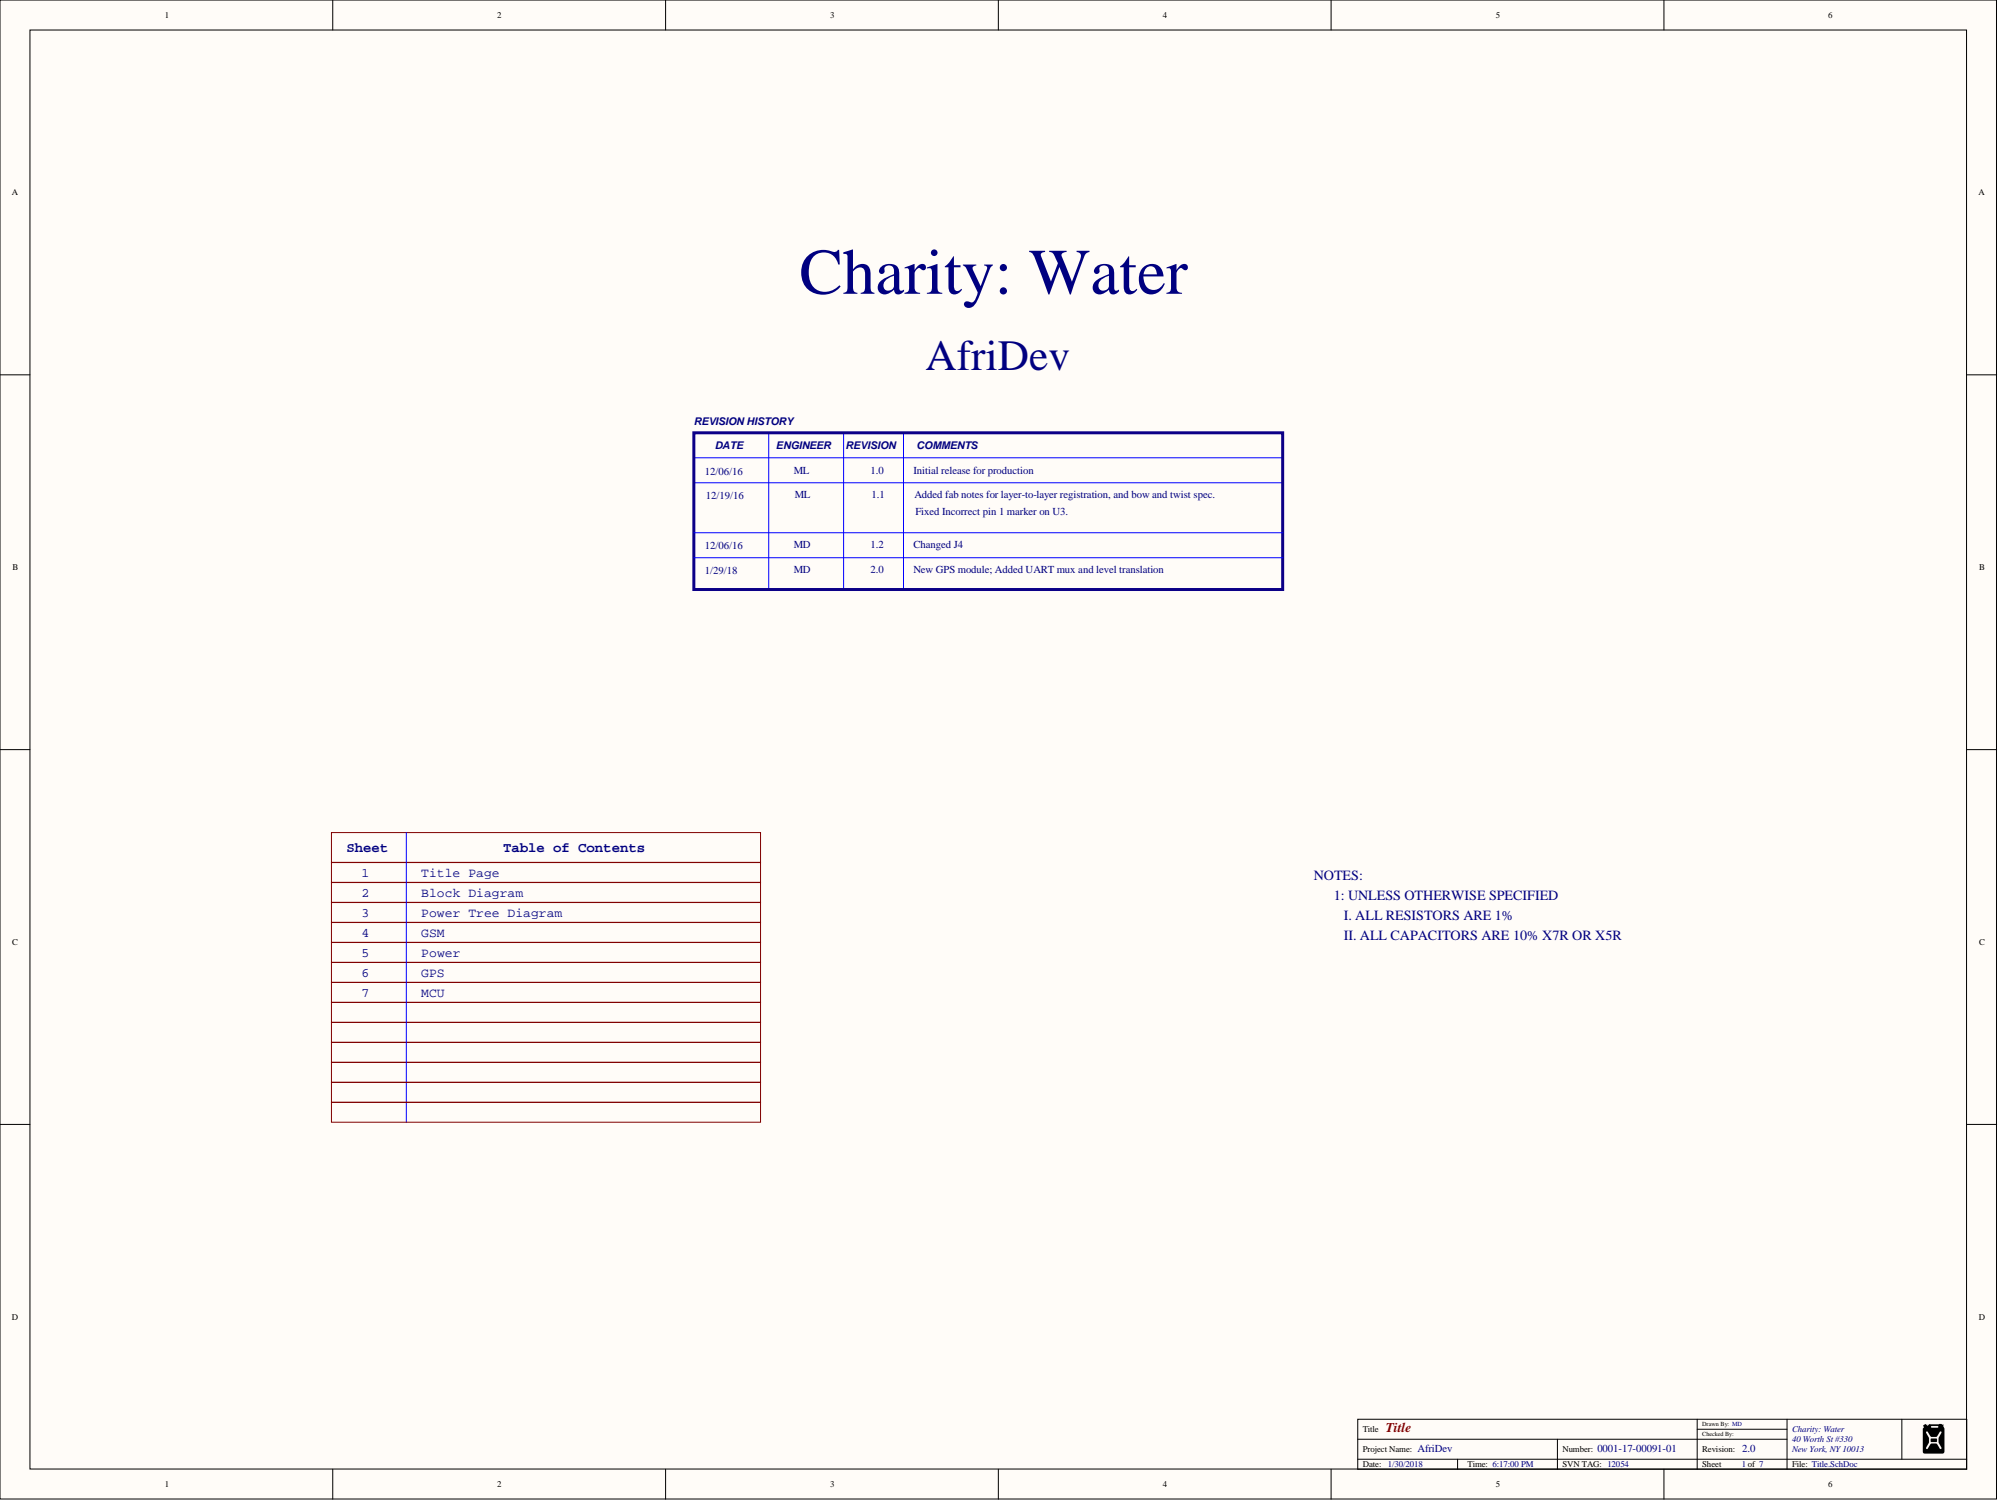
[picture p103: page 1]

DATE | ENGINEER | REVISION | COMMENTS

12/06/16 | ML | 1.0 | Initial release for production

12/19/16 | ML | 1.1 | Added fab notes for layer-to-layer registration, and bow and twist spec. Fixed Incorrect pin 1 marker on U3.

12/06/16 | MD | 1.2 | Changed J4

1/29/18 | MD | 2.0 | New GPS module; Added UART mux and level translation

Sheet | Table of Contents

1 | Title Page

NOTES:
1: UNLESS OTHERWISE SPECIFIED
I. ALL RESISTORS ARE 1%
II. ALL CAPACITORS ARE 10% X7R OR X5R

2 | Block Diagram

3 | Power Tree Diagram

4 | GSM

5 | Power

6 | GPS

7 | MCU

AfriDev Project Name: | 0001-17-00091-01 Number: | 2.0 Revision:

Date: 1/30/2018 | Time: 6:17:00 PM | SVN TAG: 12054 | Sheet of | File: Title.SchDoc

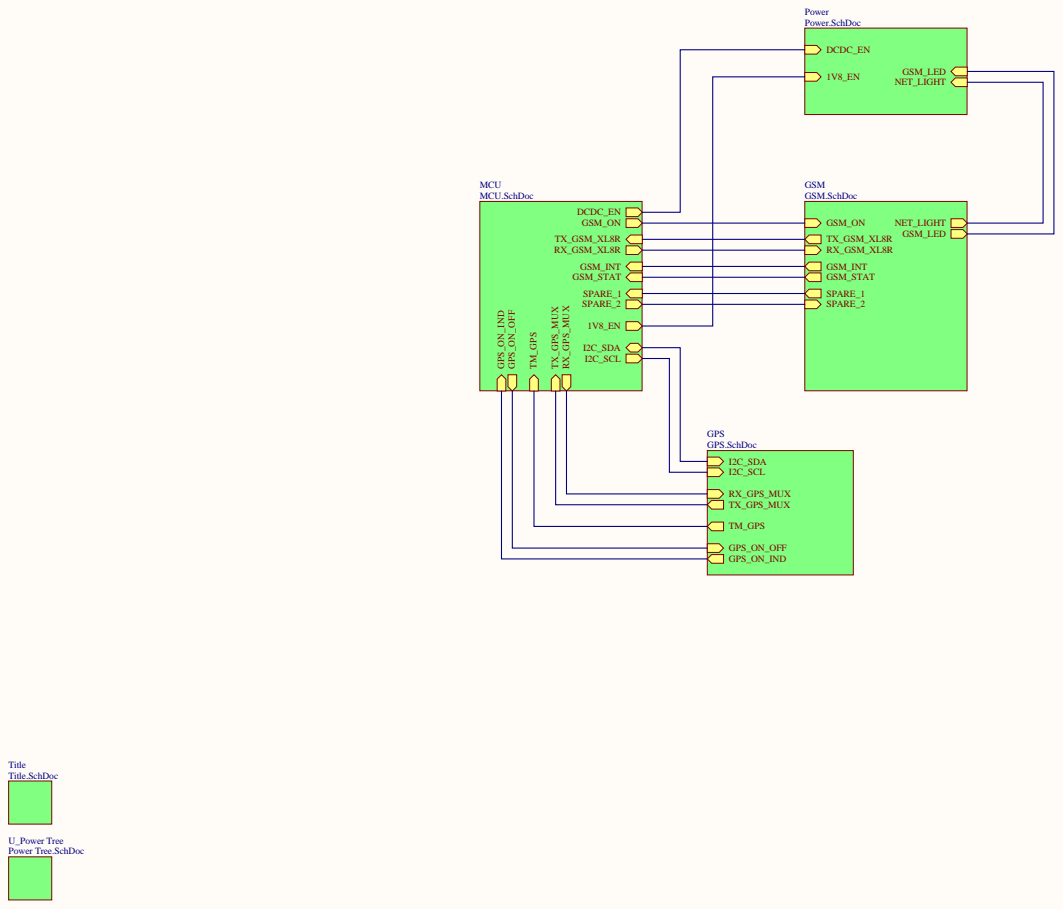
[picture p104: page 2]

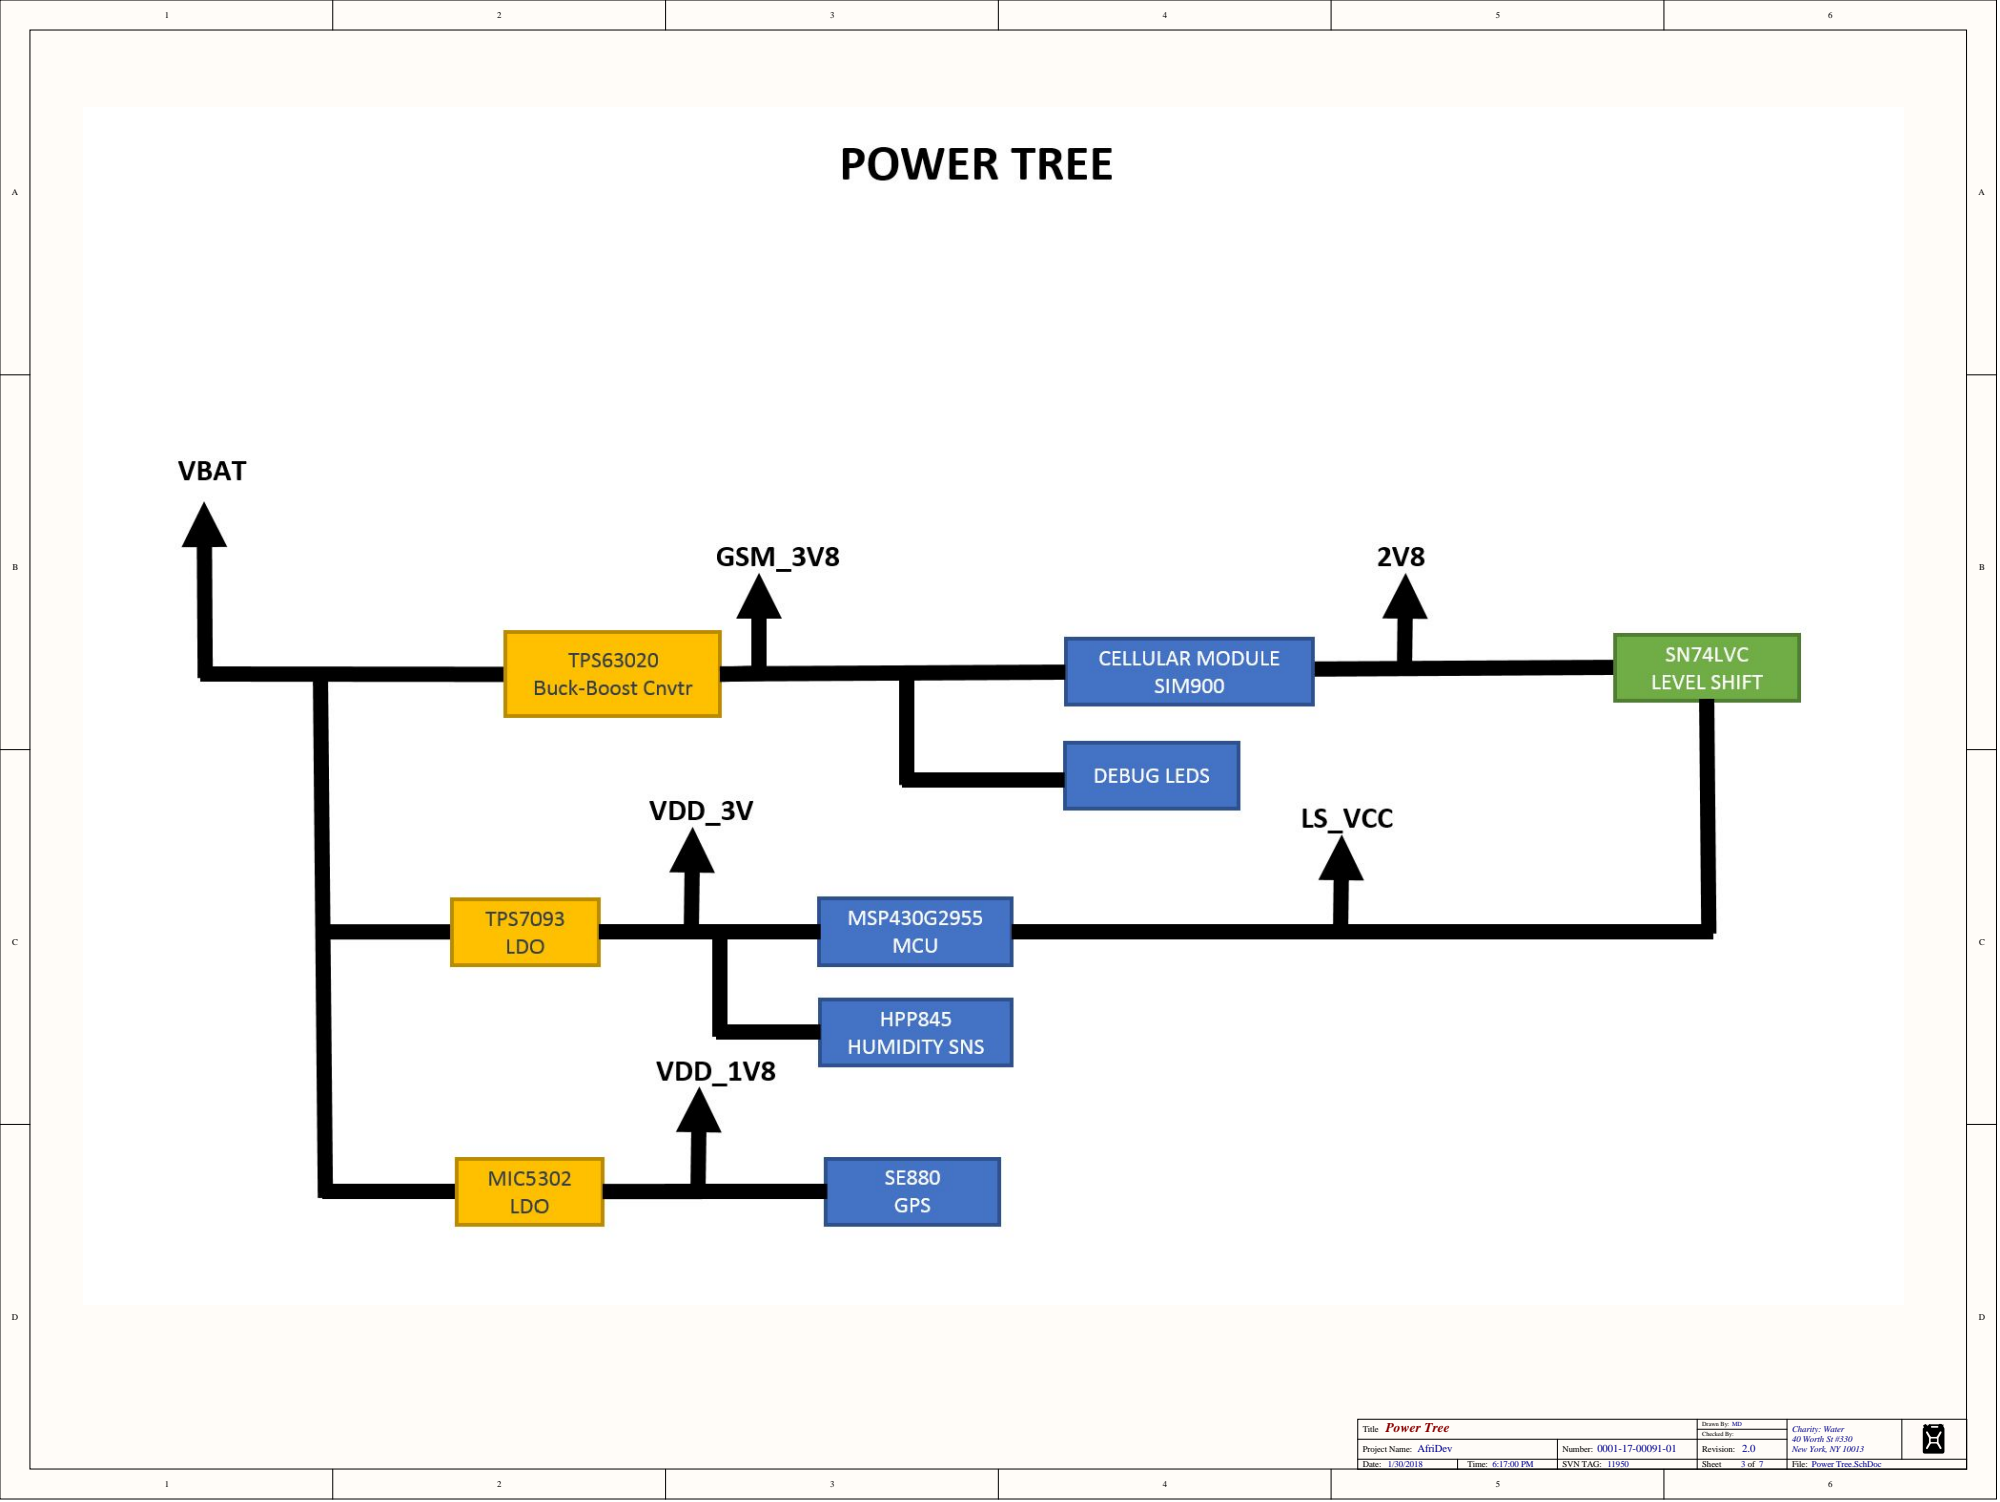
[picture p105: page 3]

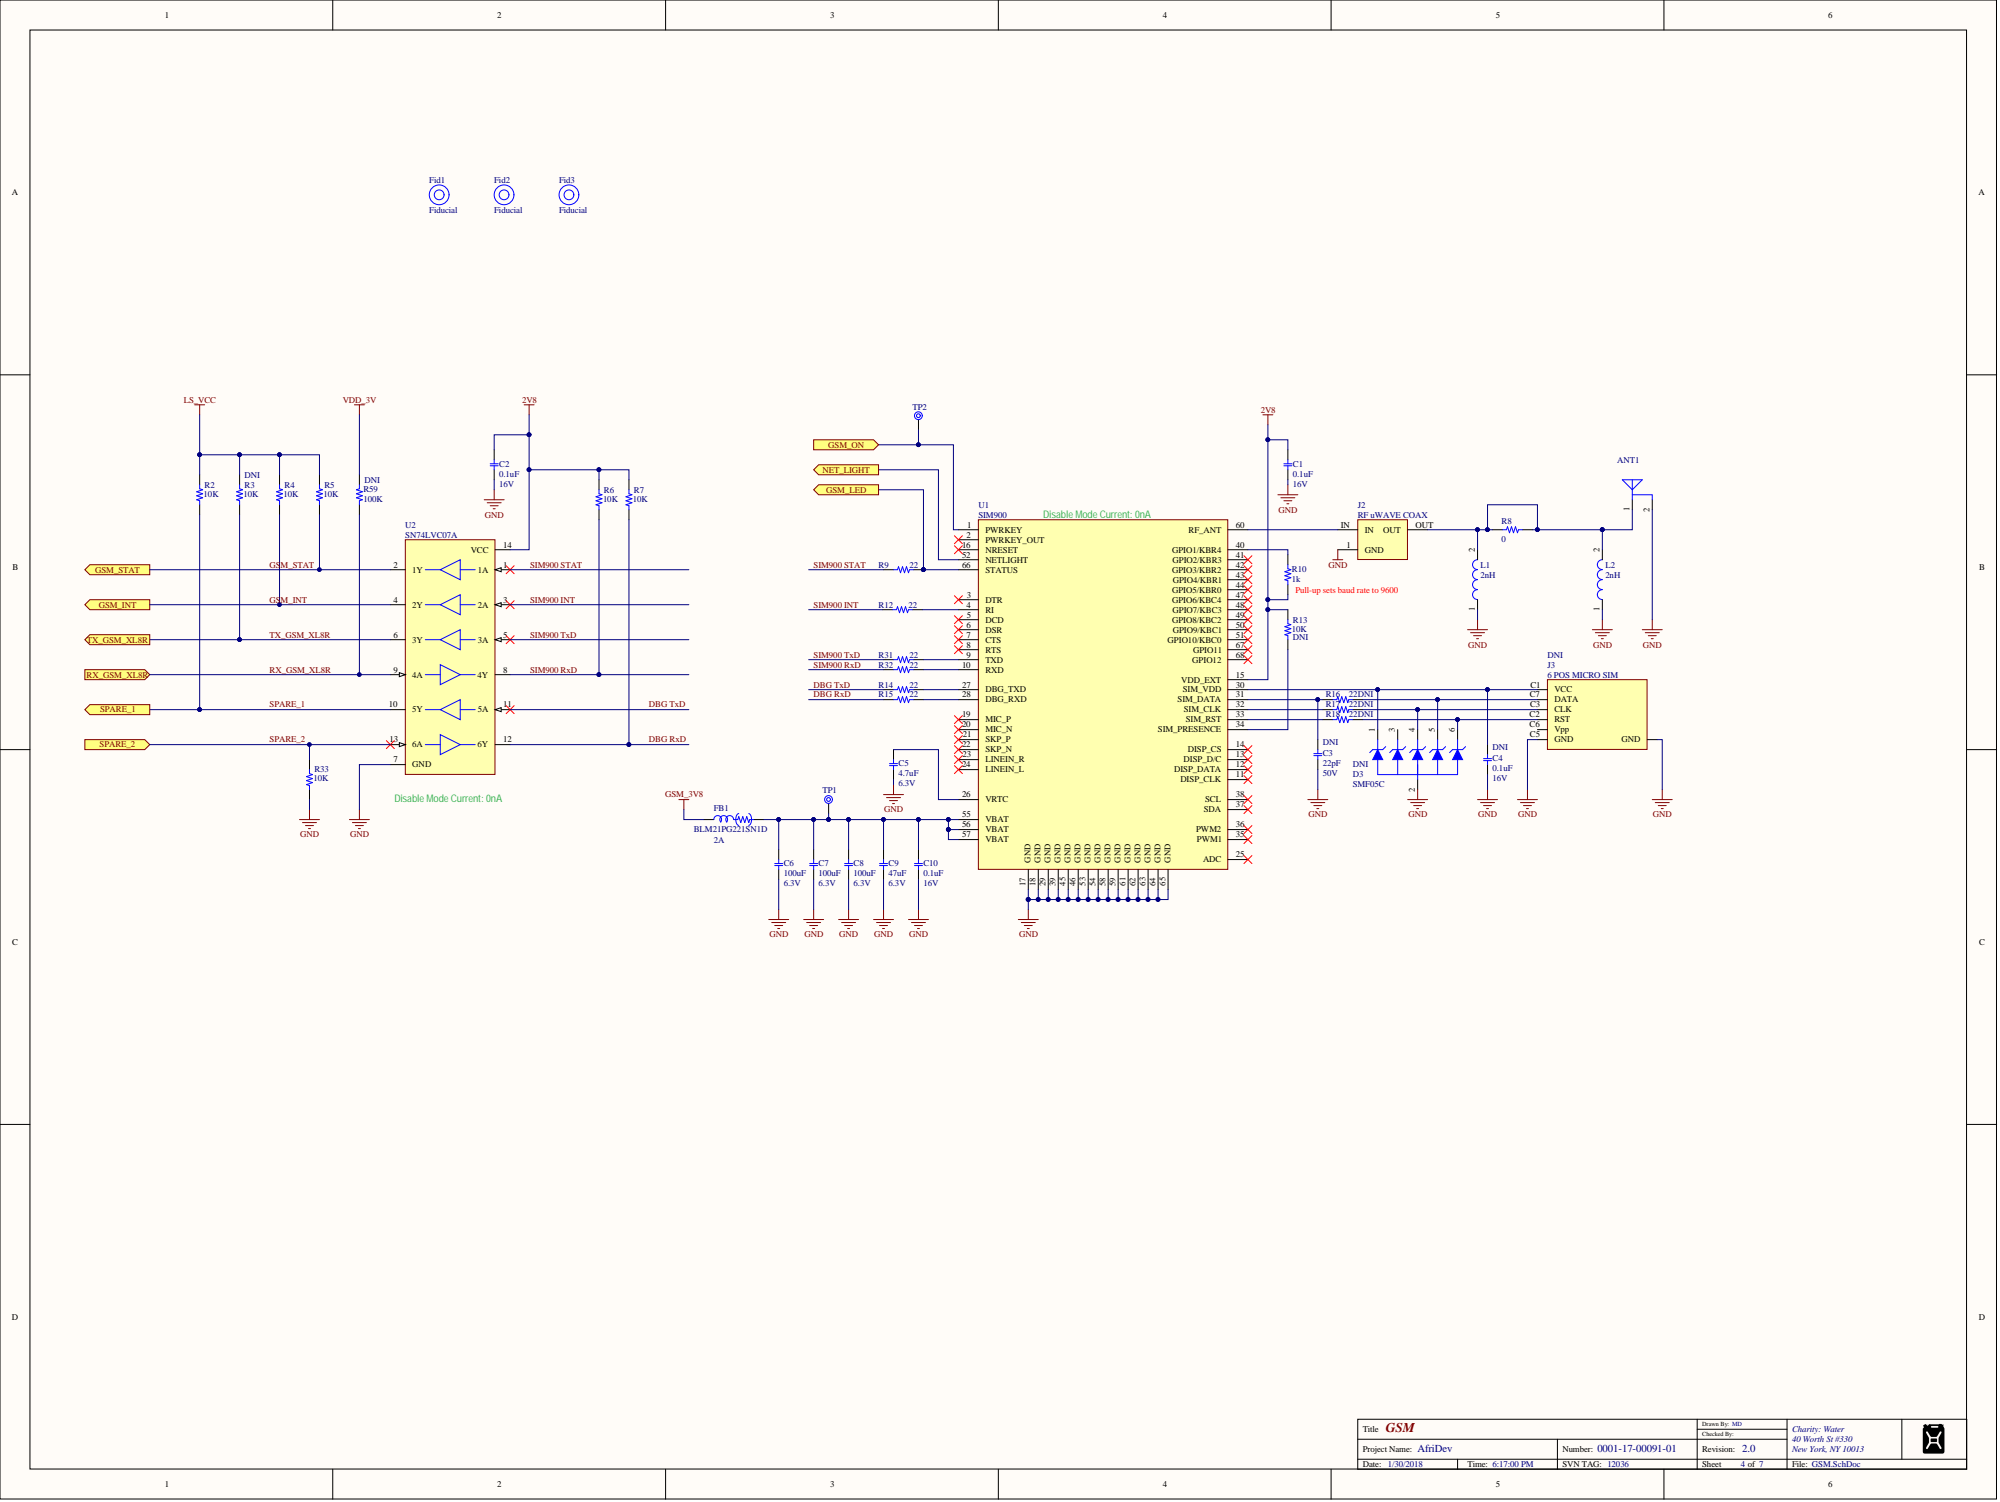
[picture p106: page 4]

Pull-up sets baud rate to 9600

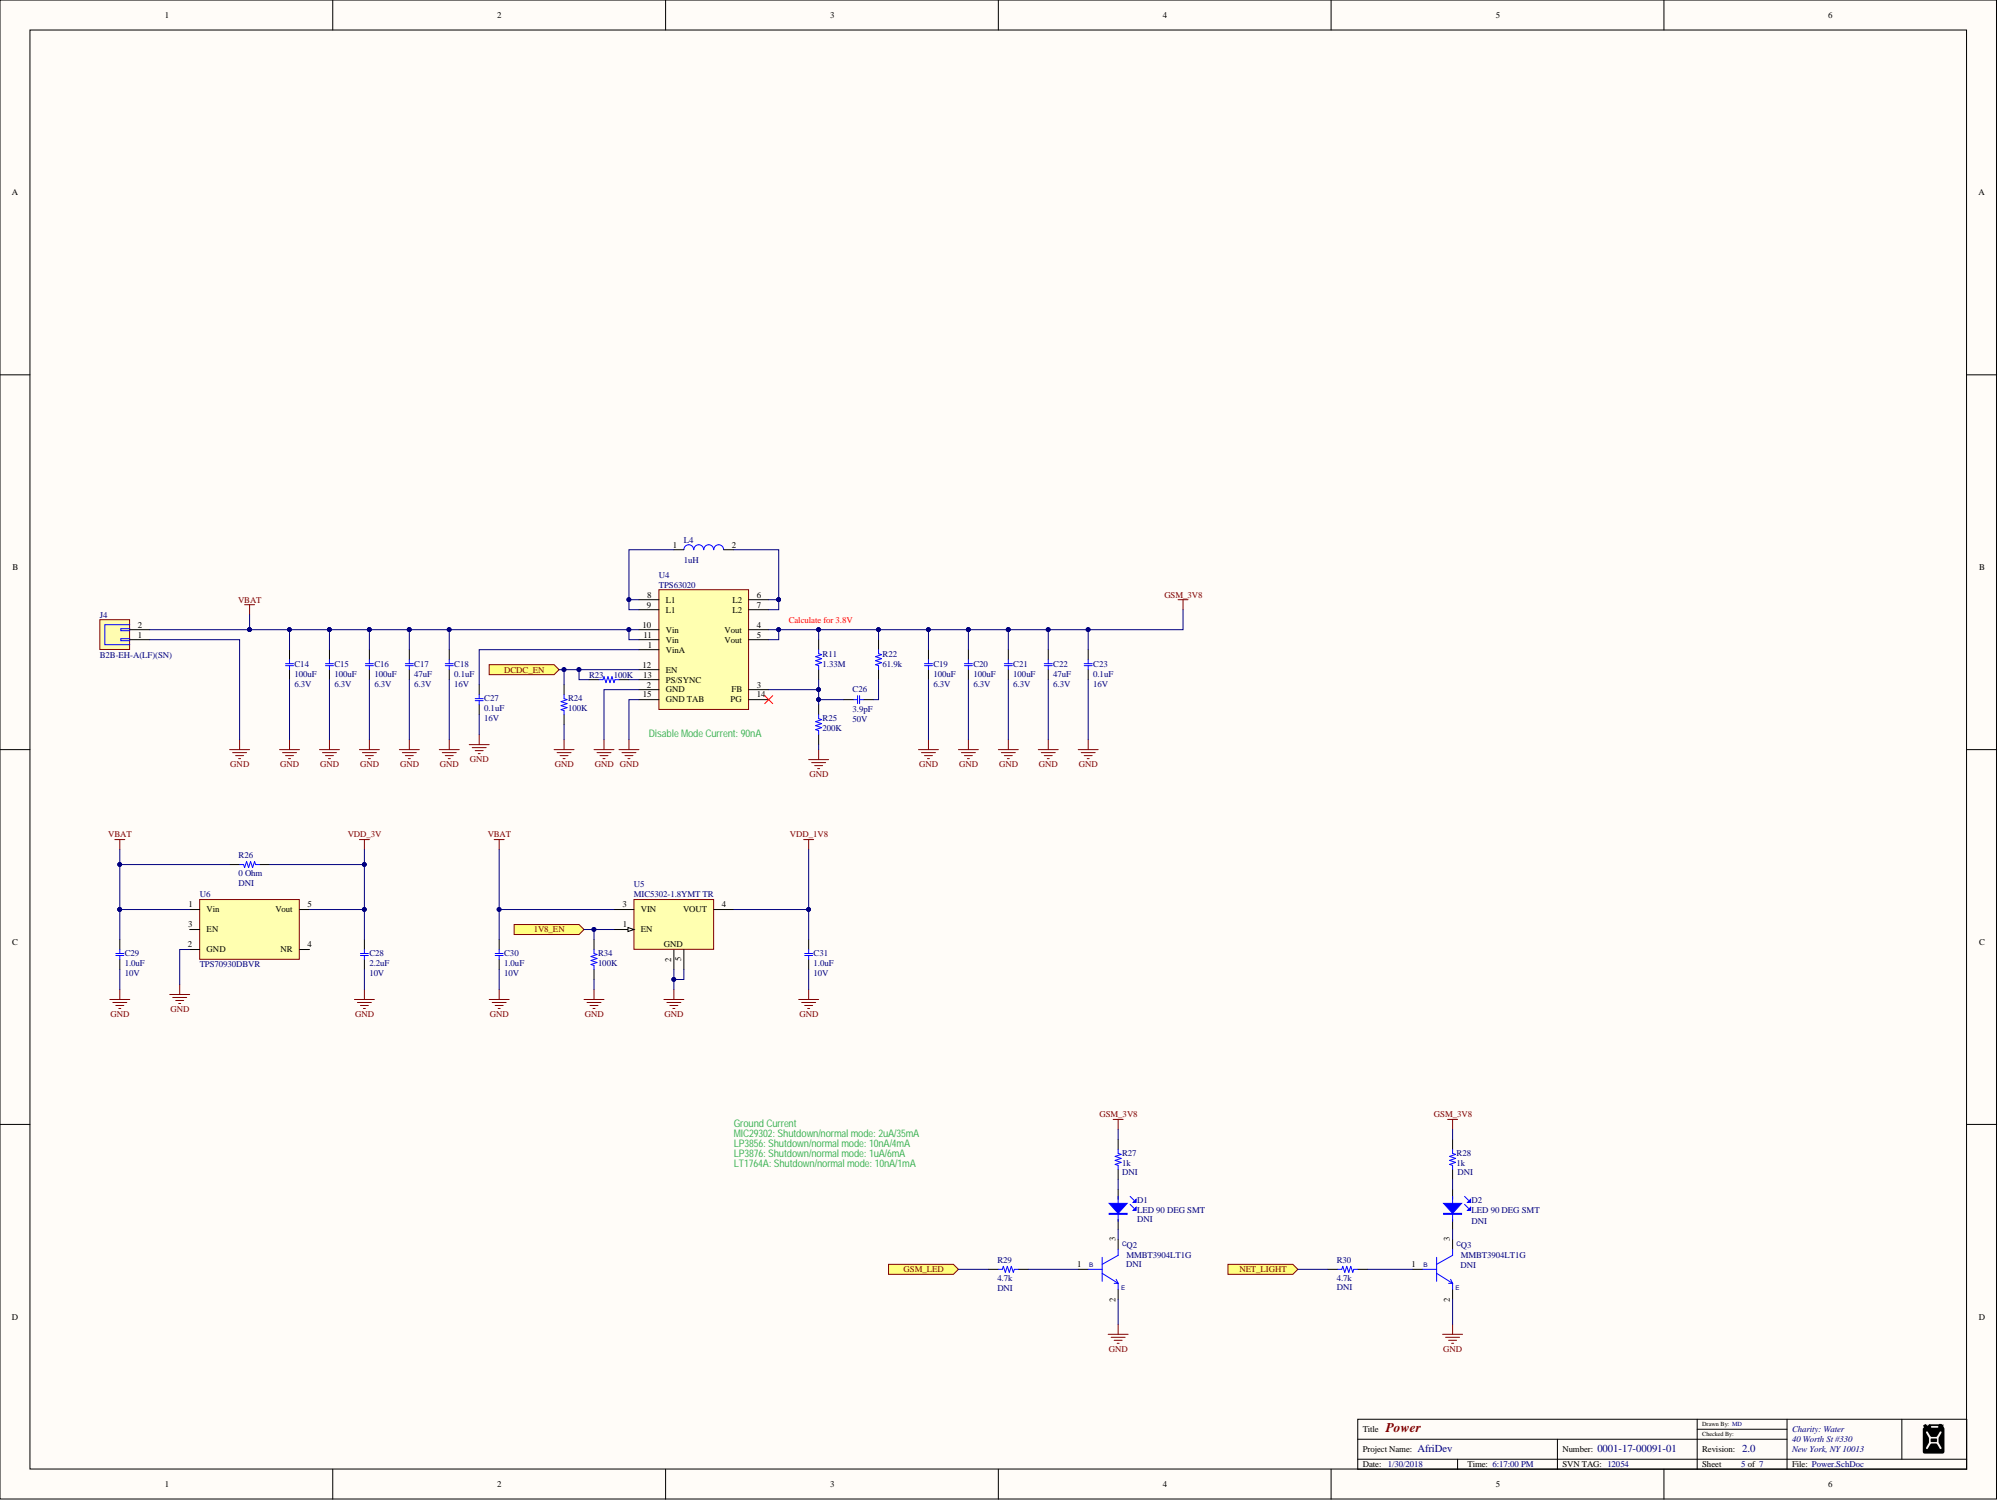
[picture p107: page 5]

EN 12
PS/SYNC 13

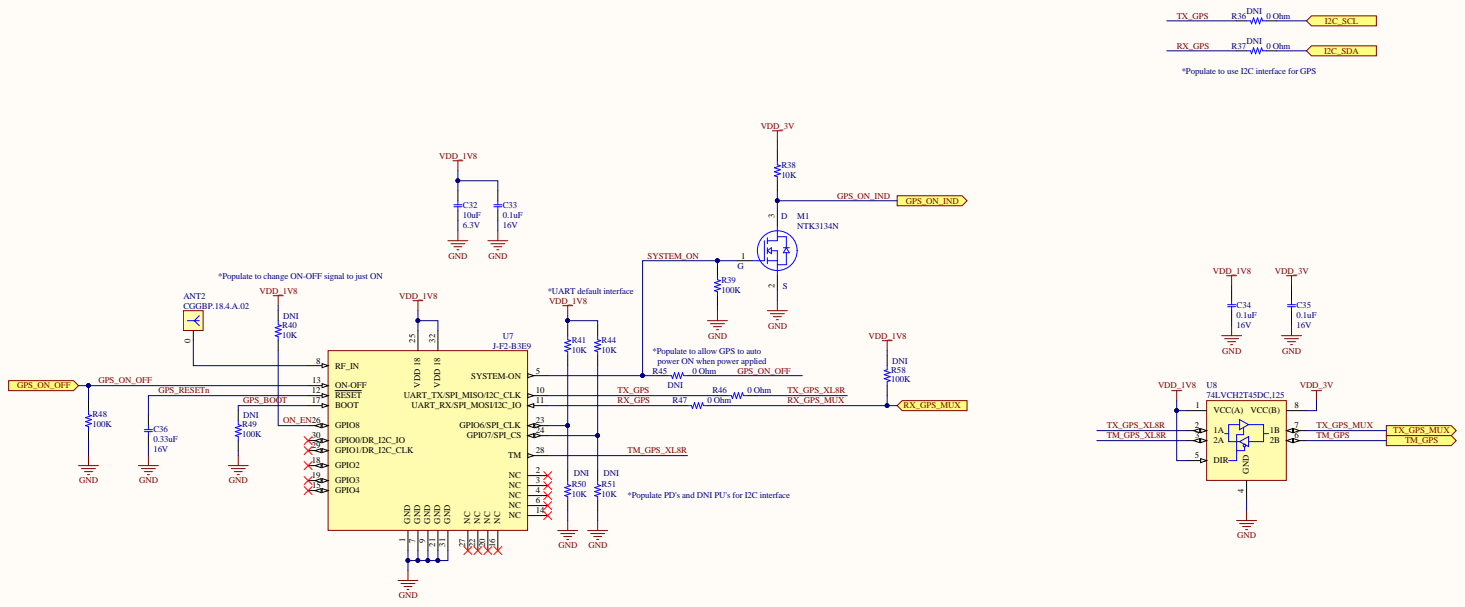
[picture p108: page 6]

*Populate to use I2C interface for GPS

*Populate to change ON-OFF signal to just ON

*Populate to allow GPS to auto
power ON when power applied

GPS_BOOT | BOOT 17

VCC(A) 1

GPIO8 26

1A 2 2A 3 DIR 5

*Populate PD's and DNI PU's for I2C interface

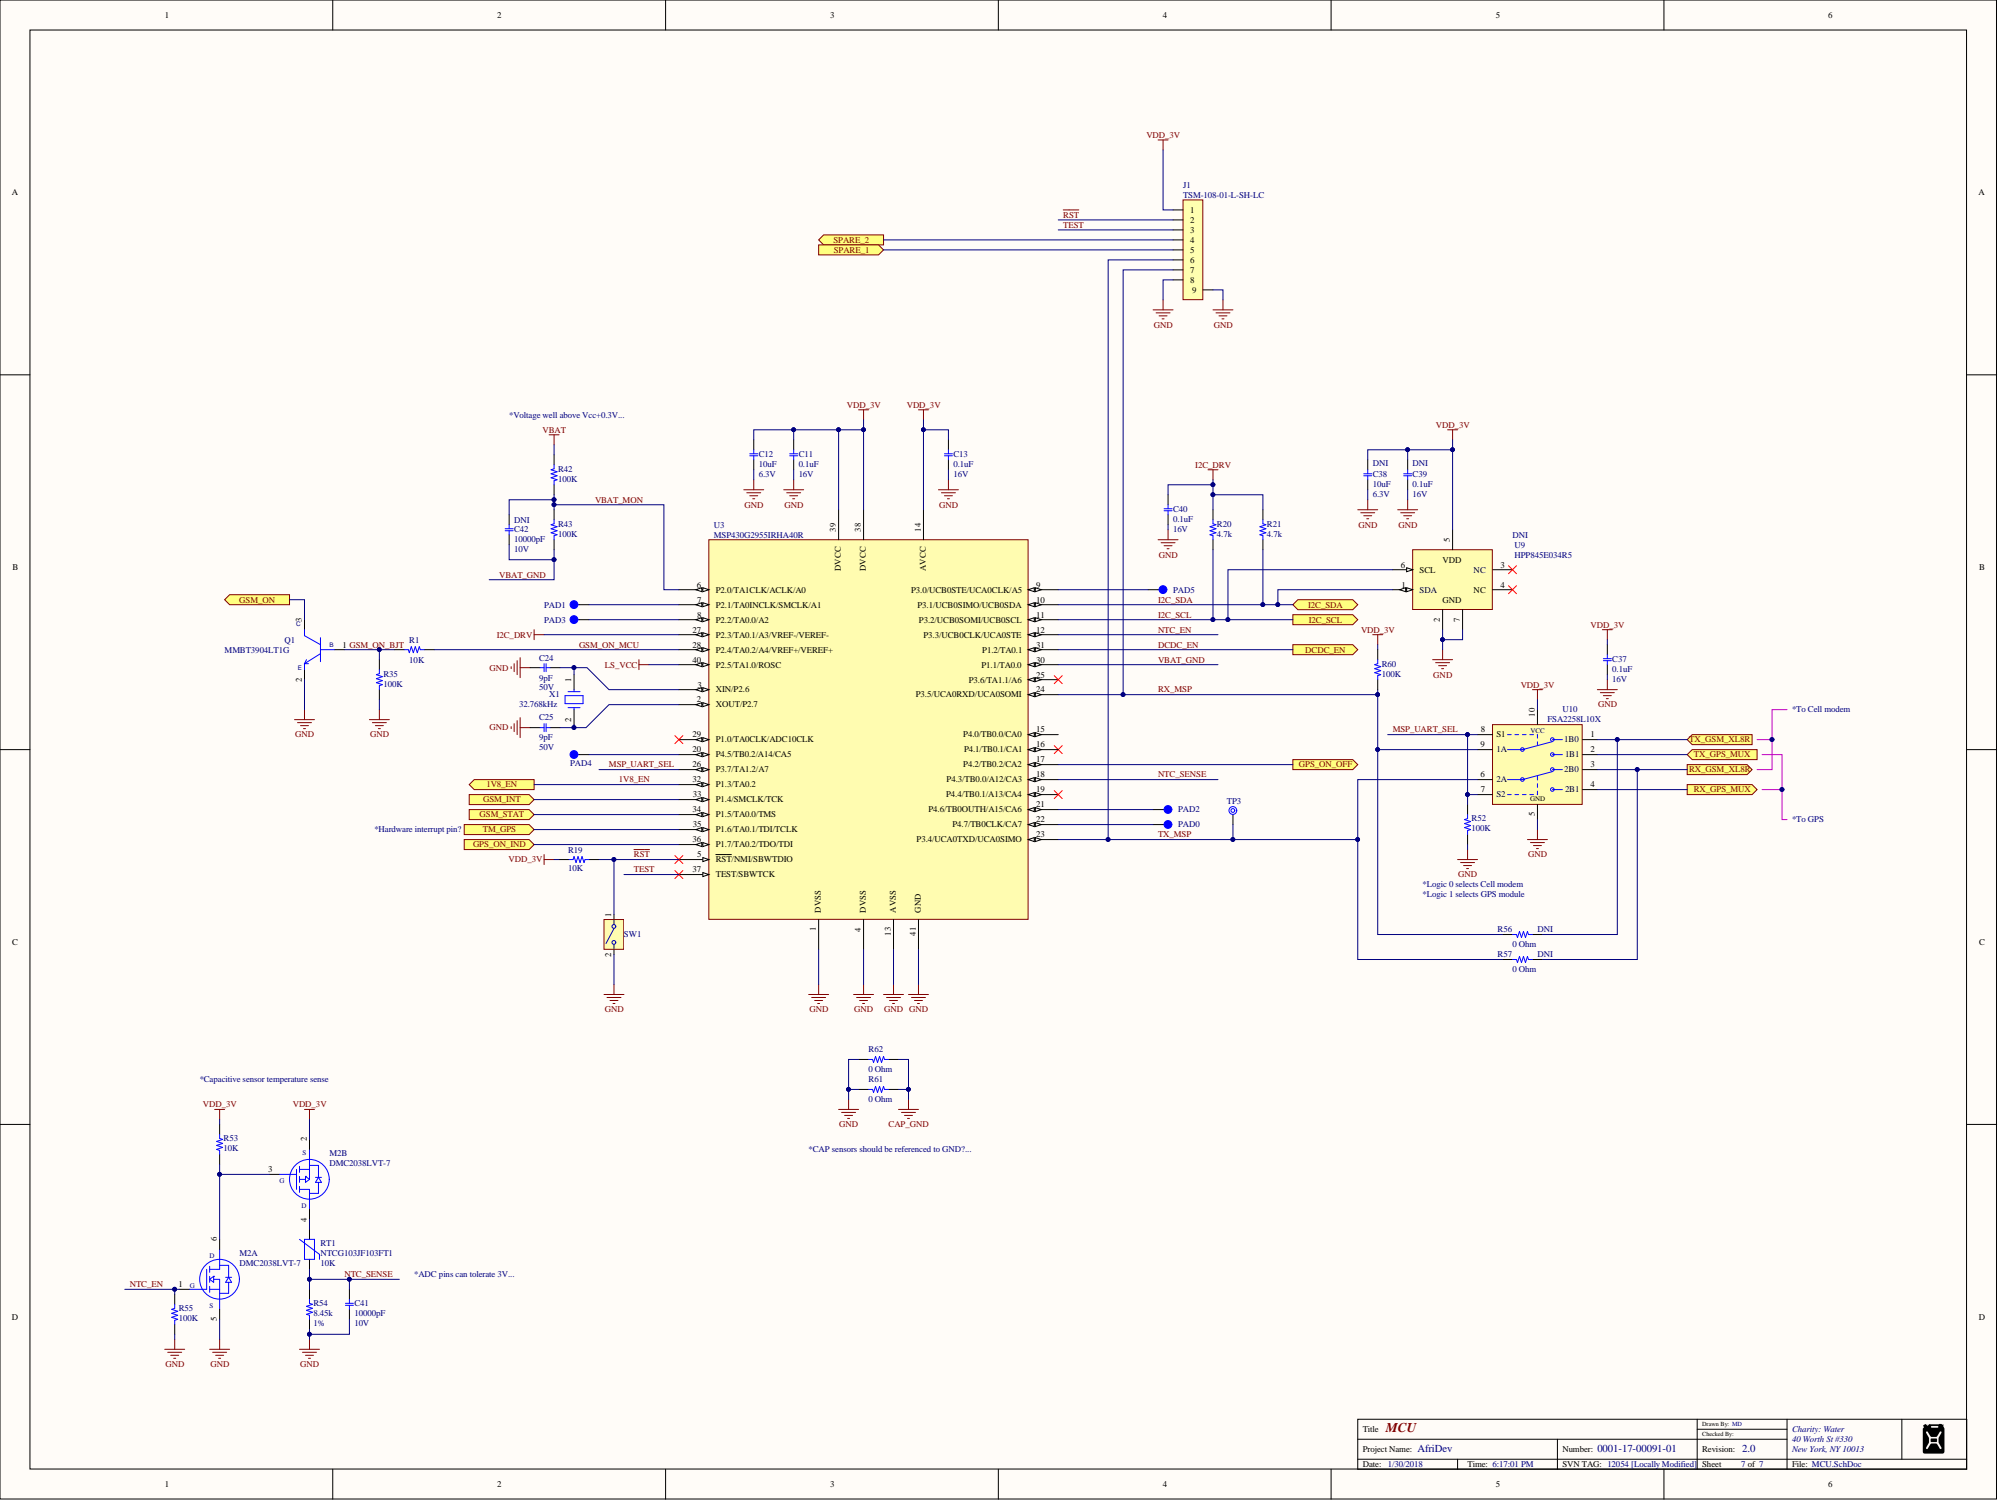
[picture p109: page 7]

*Voltage well above Vcc+0.3V...

*Logic 0 selects Cell modem
*Logic 1 selects GPS module

*Capacitive sensor temperature sense

*CAP sensors should be referenced to GND?...

*ADC pins can tolerate 3V...

SVN TAG: 12054 [Locally Modified]
