charitywater/afridev2-sensor/software/specifications/Visio-CWSTATE.pdf

# INITIALIZE LOCATE

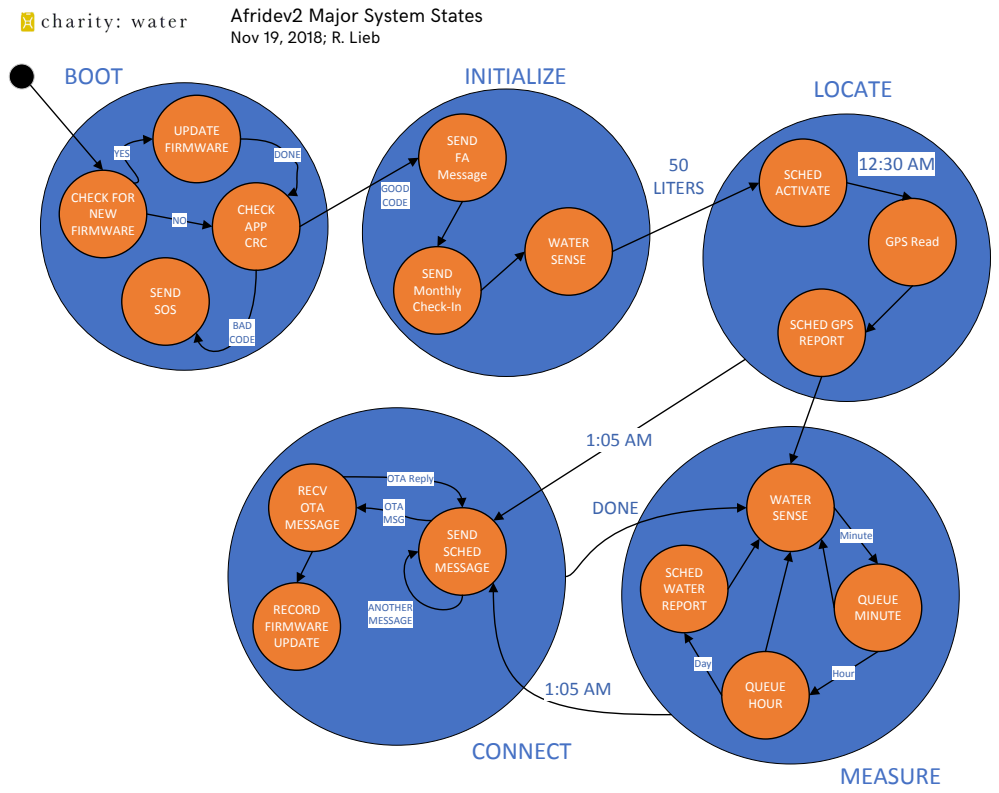
[picture p110: page 1]
SEND FA Message; SEND Monthly Check‐In; WATER SENSE; SCHED ACTIVATE; GPS Read; SCHED GPS REPORT; LITERS; QUEUE MINUTE; QUEUE HOUR; MEASURE; Minute; Hour; SCHED WATER REPORT; Day; SEND SCHED MESSAGE; CONNECT; ANOTHER MESSAGE; DONE; RECV OTA MESSAGE; RECORD FIRMWARE UPDATE; OTA MSG; BOOT; UPDATE FIRMWARE; CHECK APP CRC; GOOD CODE; SEND SOS; BAD CODE; OTA Reply; CHECK FOR NEW FIRMWARE; YES

Afridev2 Major System States
Nov 19, 2018; R. Lieb
