charitywater/afridev2-sensor/hardware/EE Drawings/Afridev_rev2_ProductionFiles_013018/Assembly Drawings/AfriDev_Rev2.0_3D_View.PDF

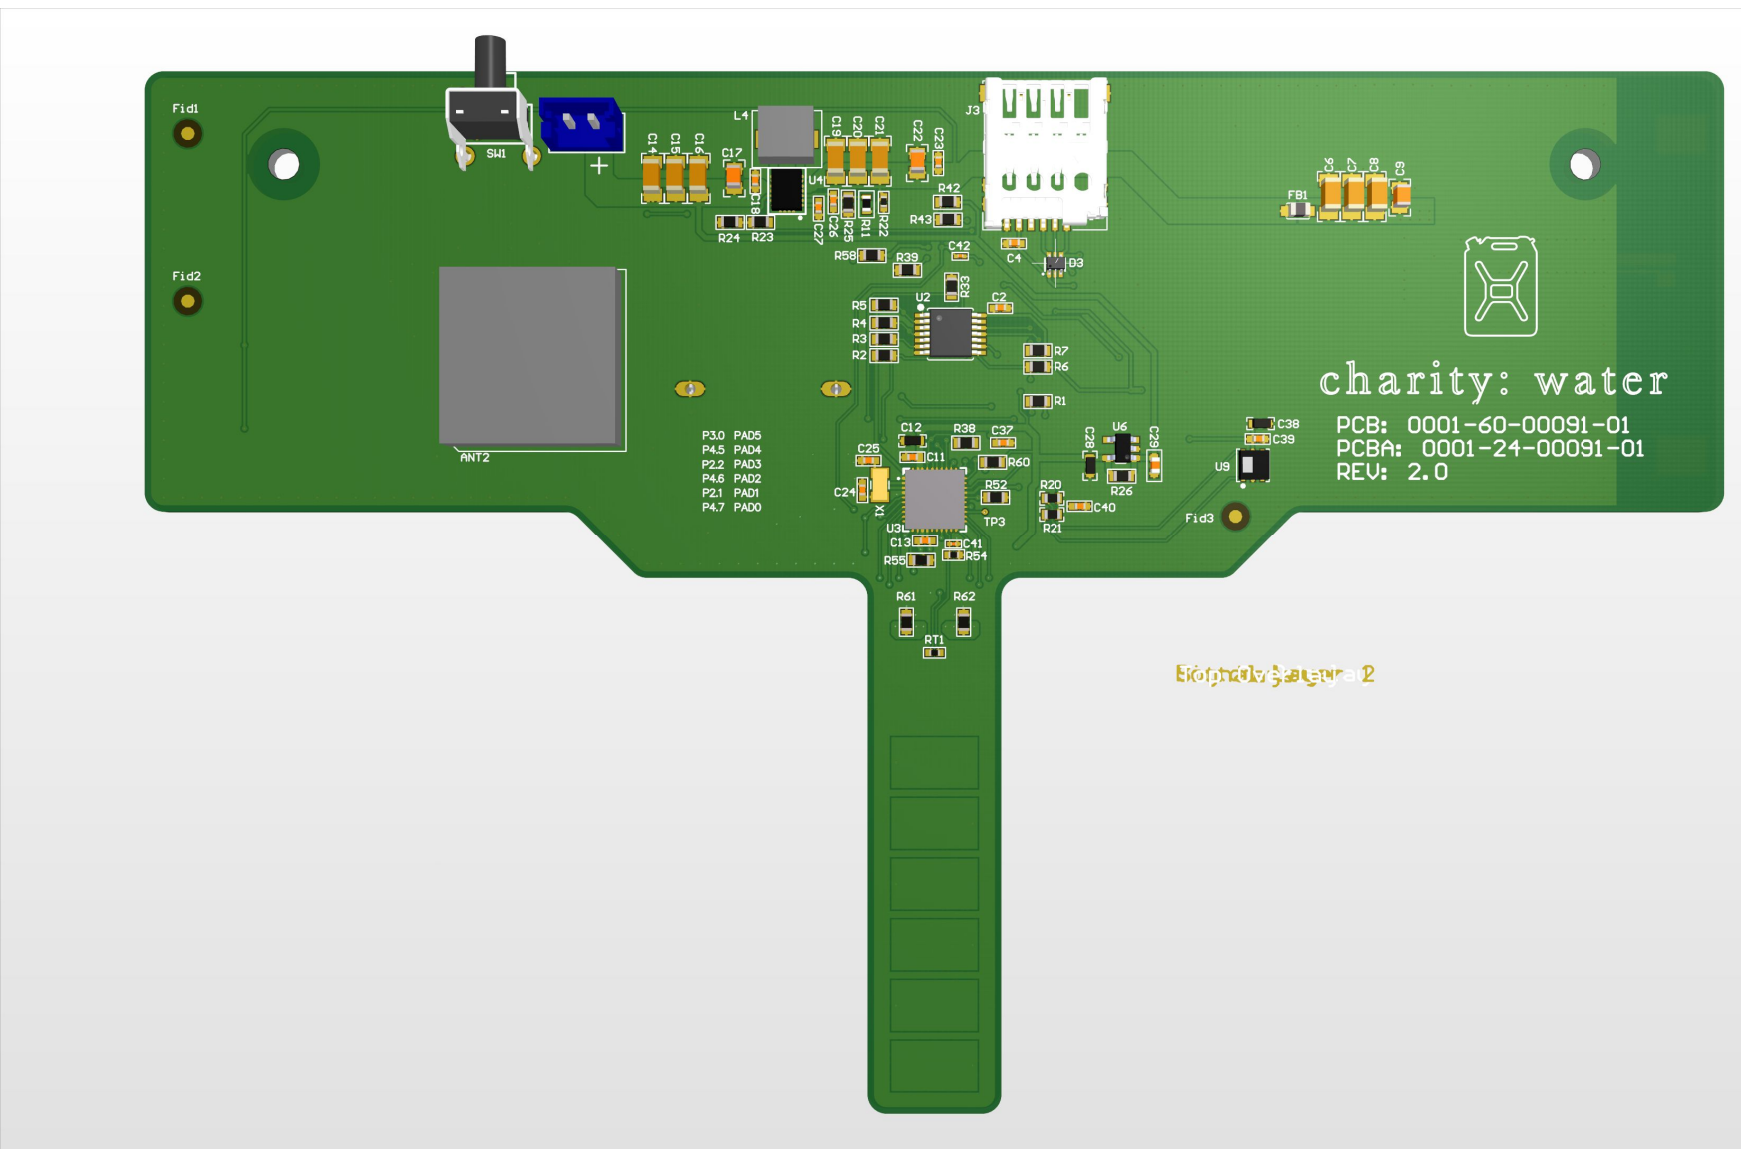
[picture p111: page 1]

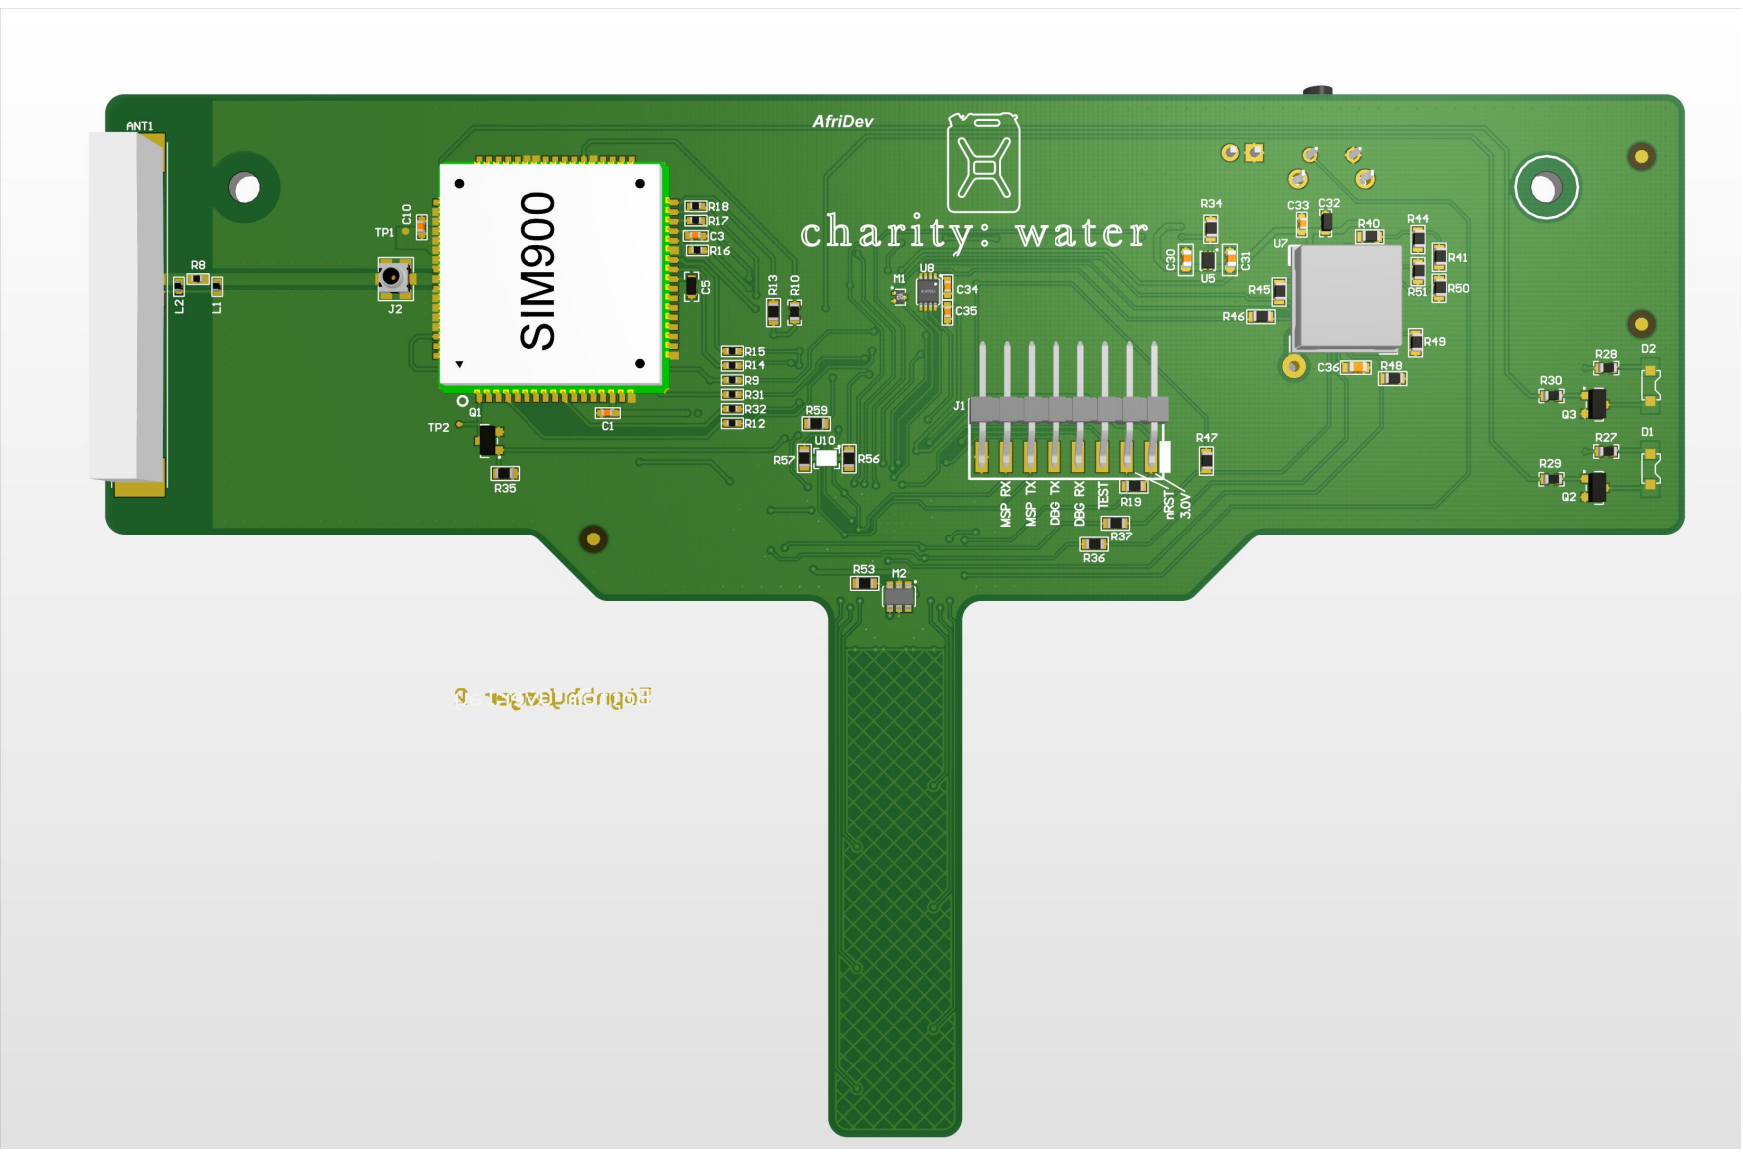
[picture p112: page 2]

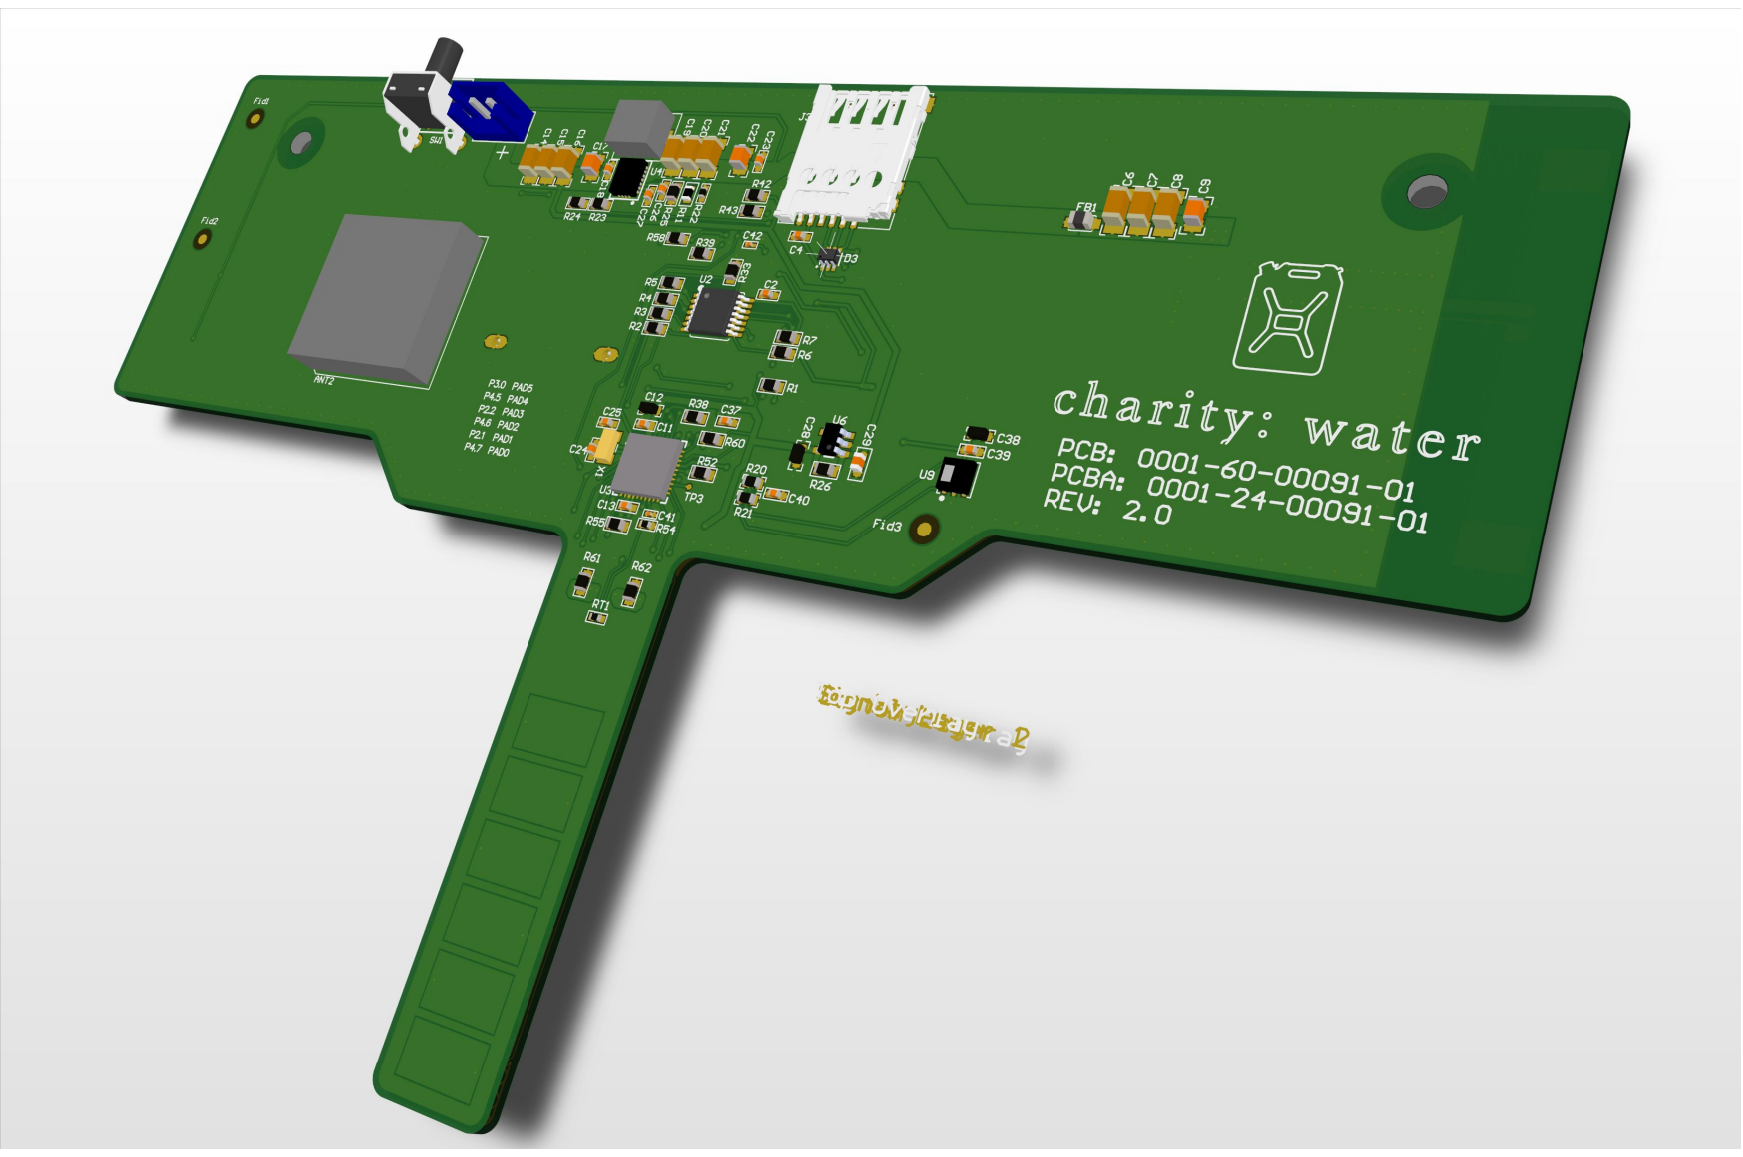
[picture p113: page 3]

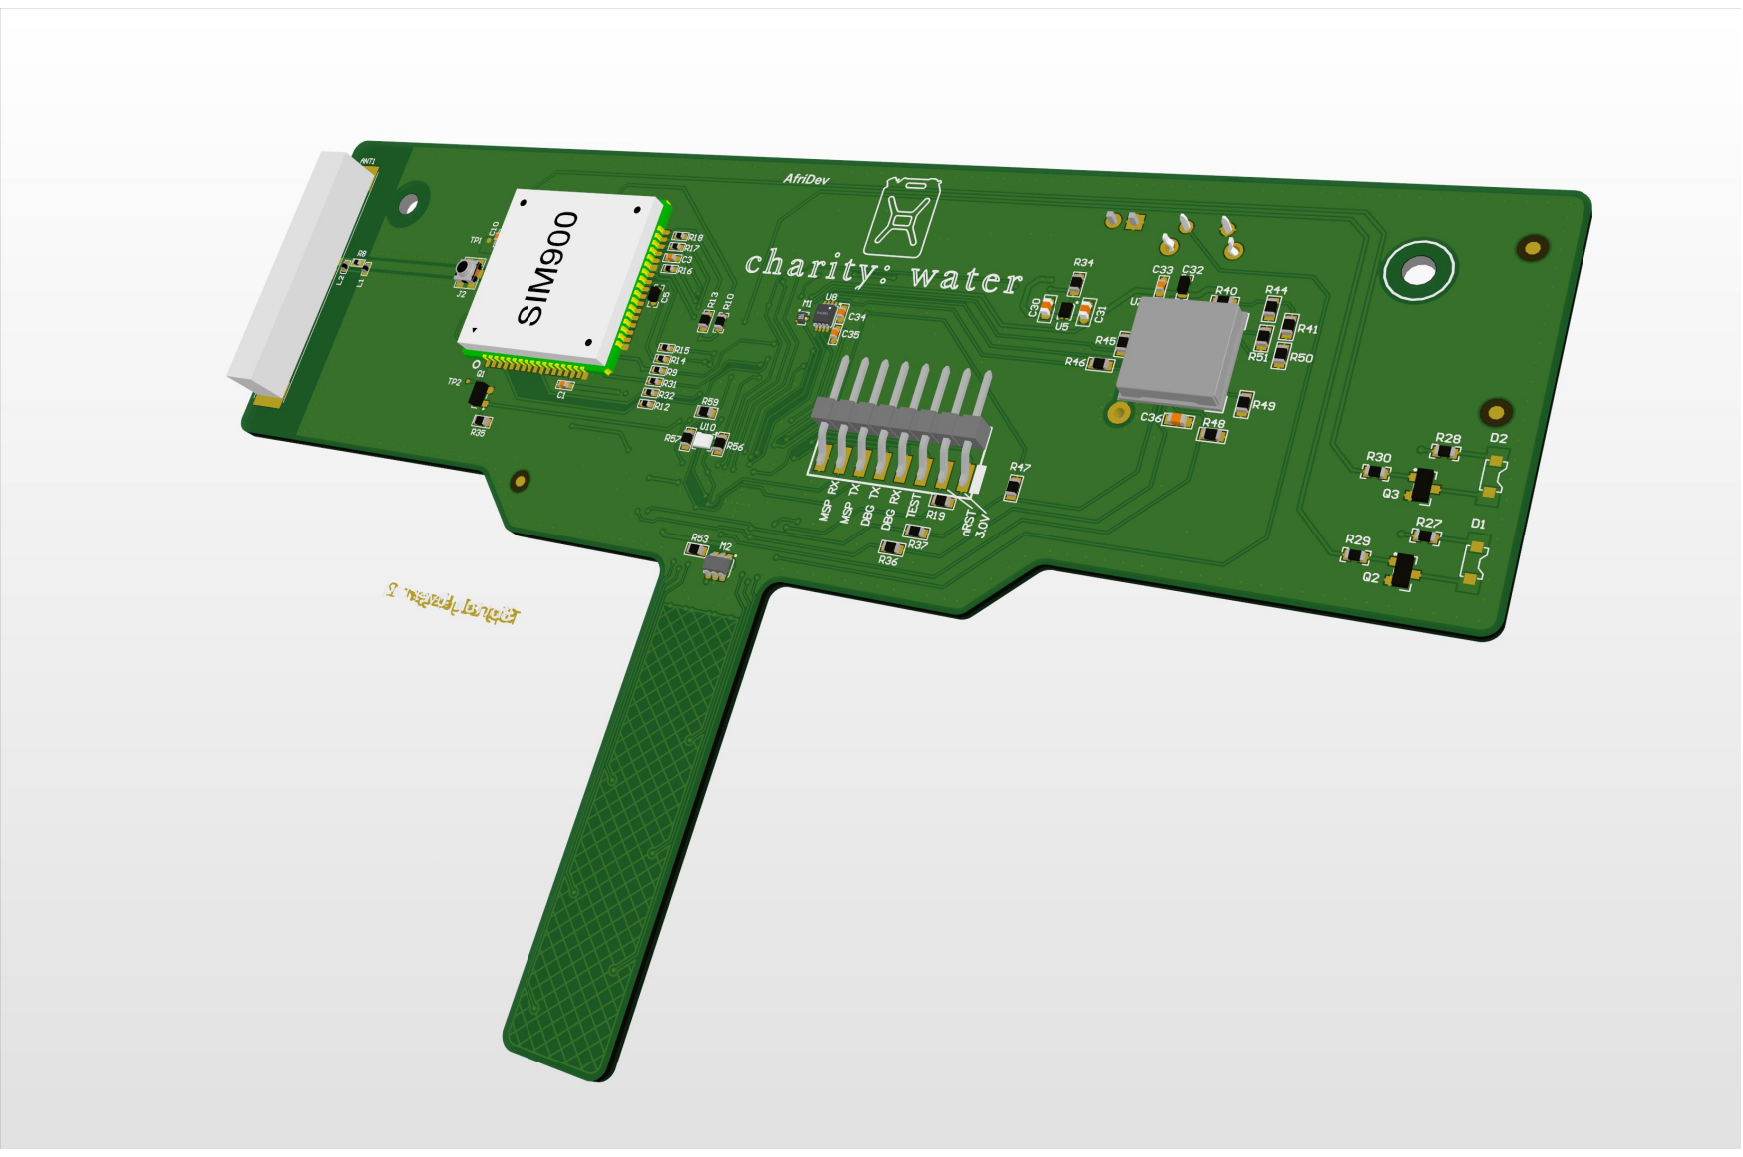
[picture p114: page 4]
