charitywater/afridev2-sensor/hardware/EE Drawings/Afridev_rev2_ProductionFiles_013018/Assembly Drawings/AfriDev_Rev2.0_AssemblyDrawings.PDF

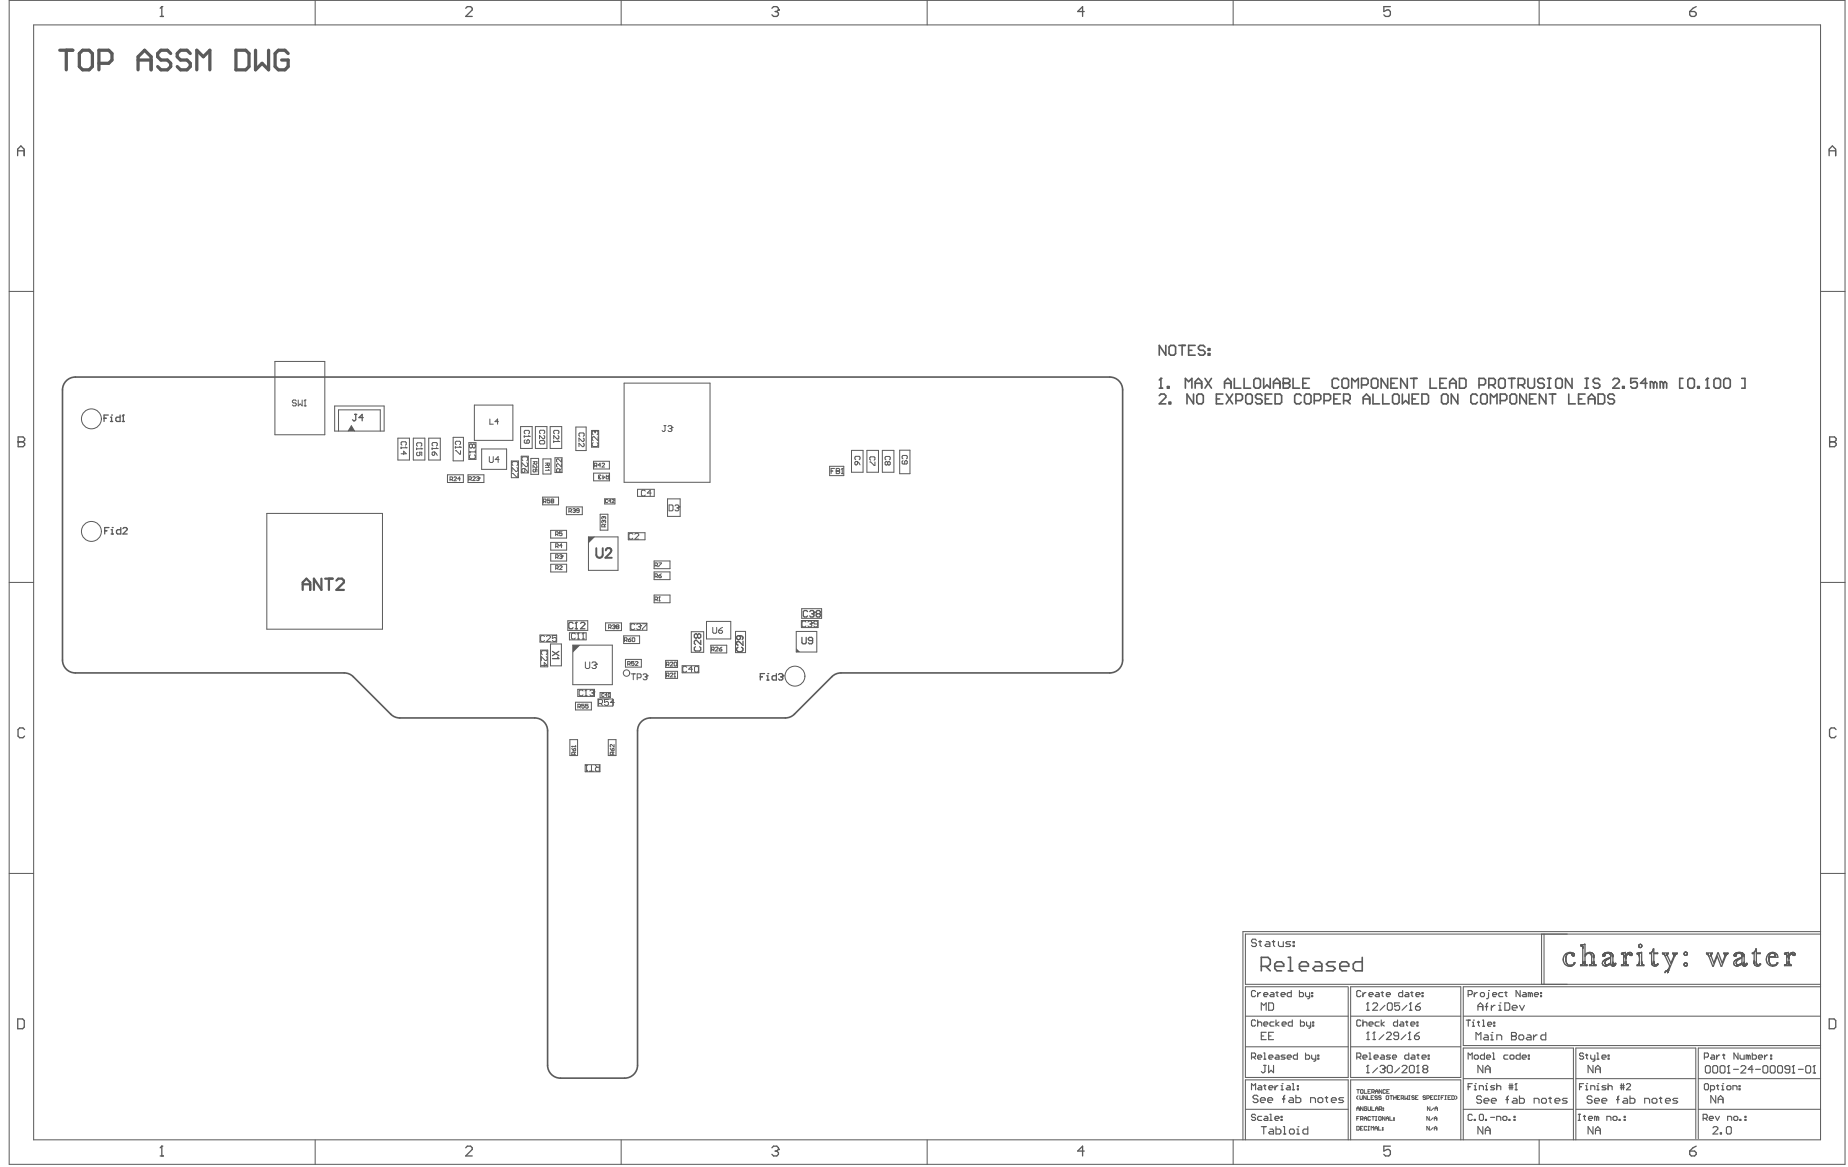
[picture p115: page 1]

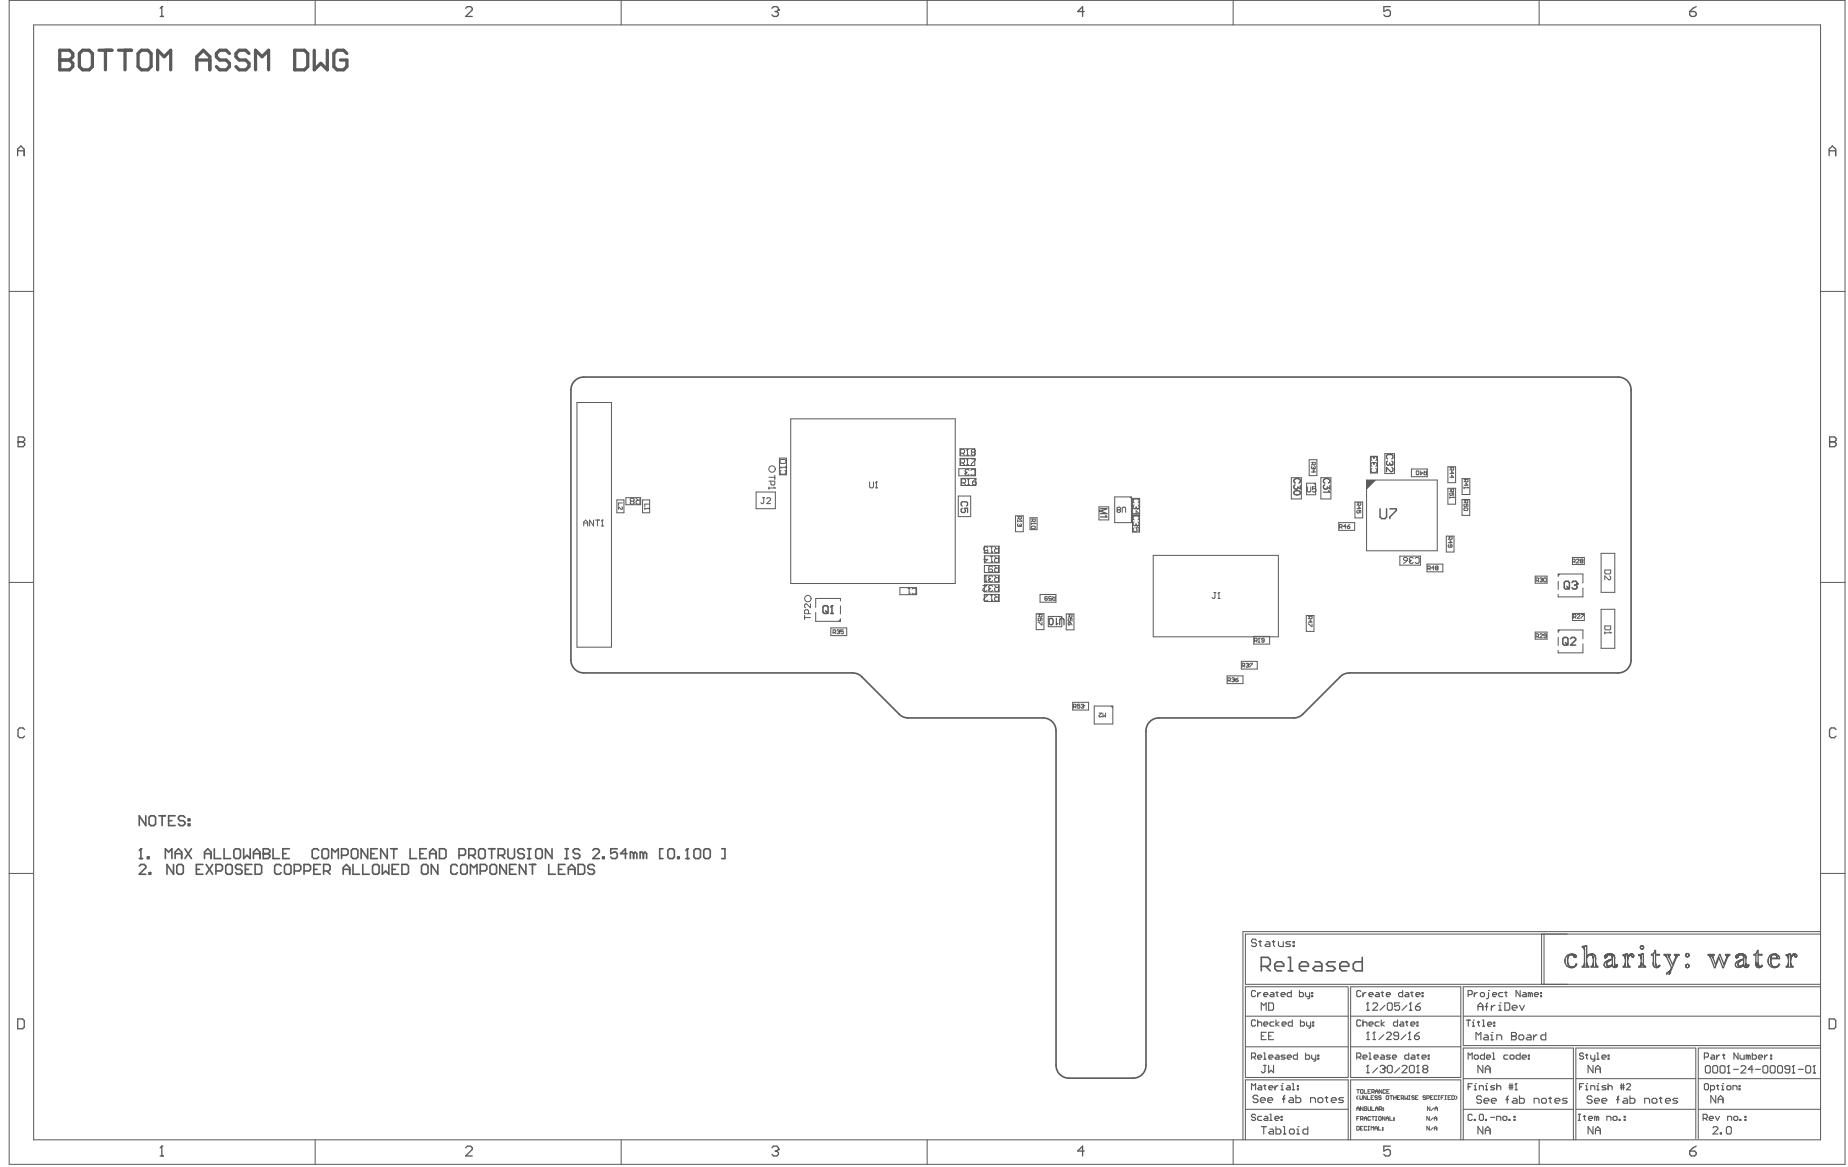
[picture p116: page 2]
