charitywater/afridev2-sensor/hardware/EE Drawings/Afridev_rev2_ProductionFiles_013018/Fabrication Drawings/AfriDev_Rev2.0_DrillDrawing_Guide.PDF

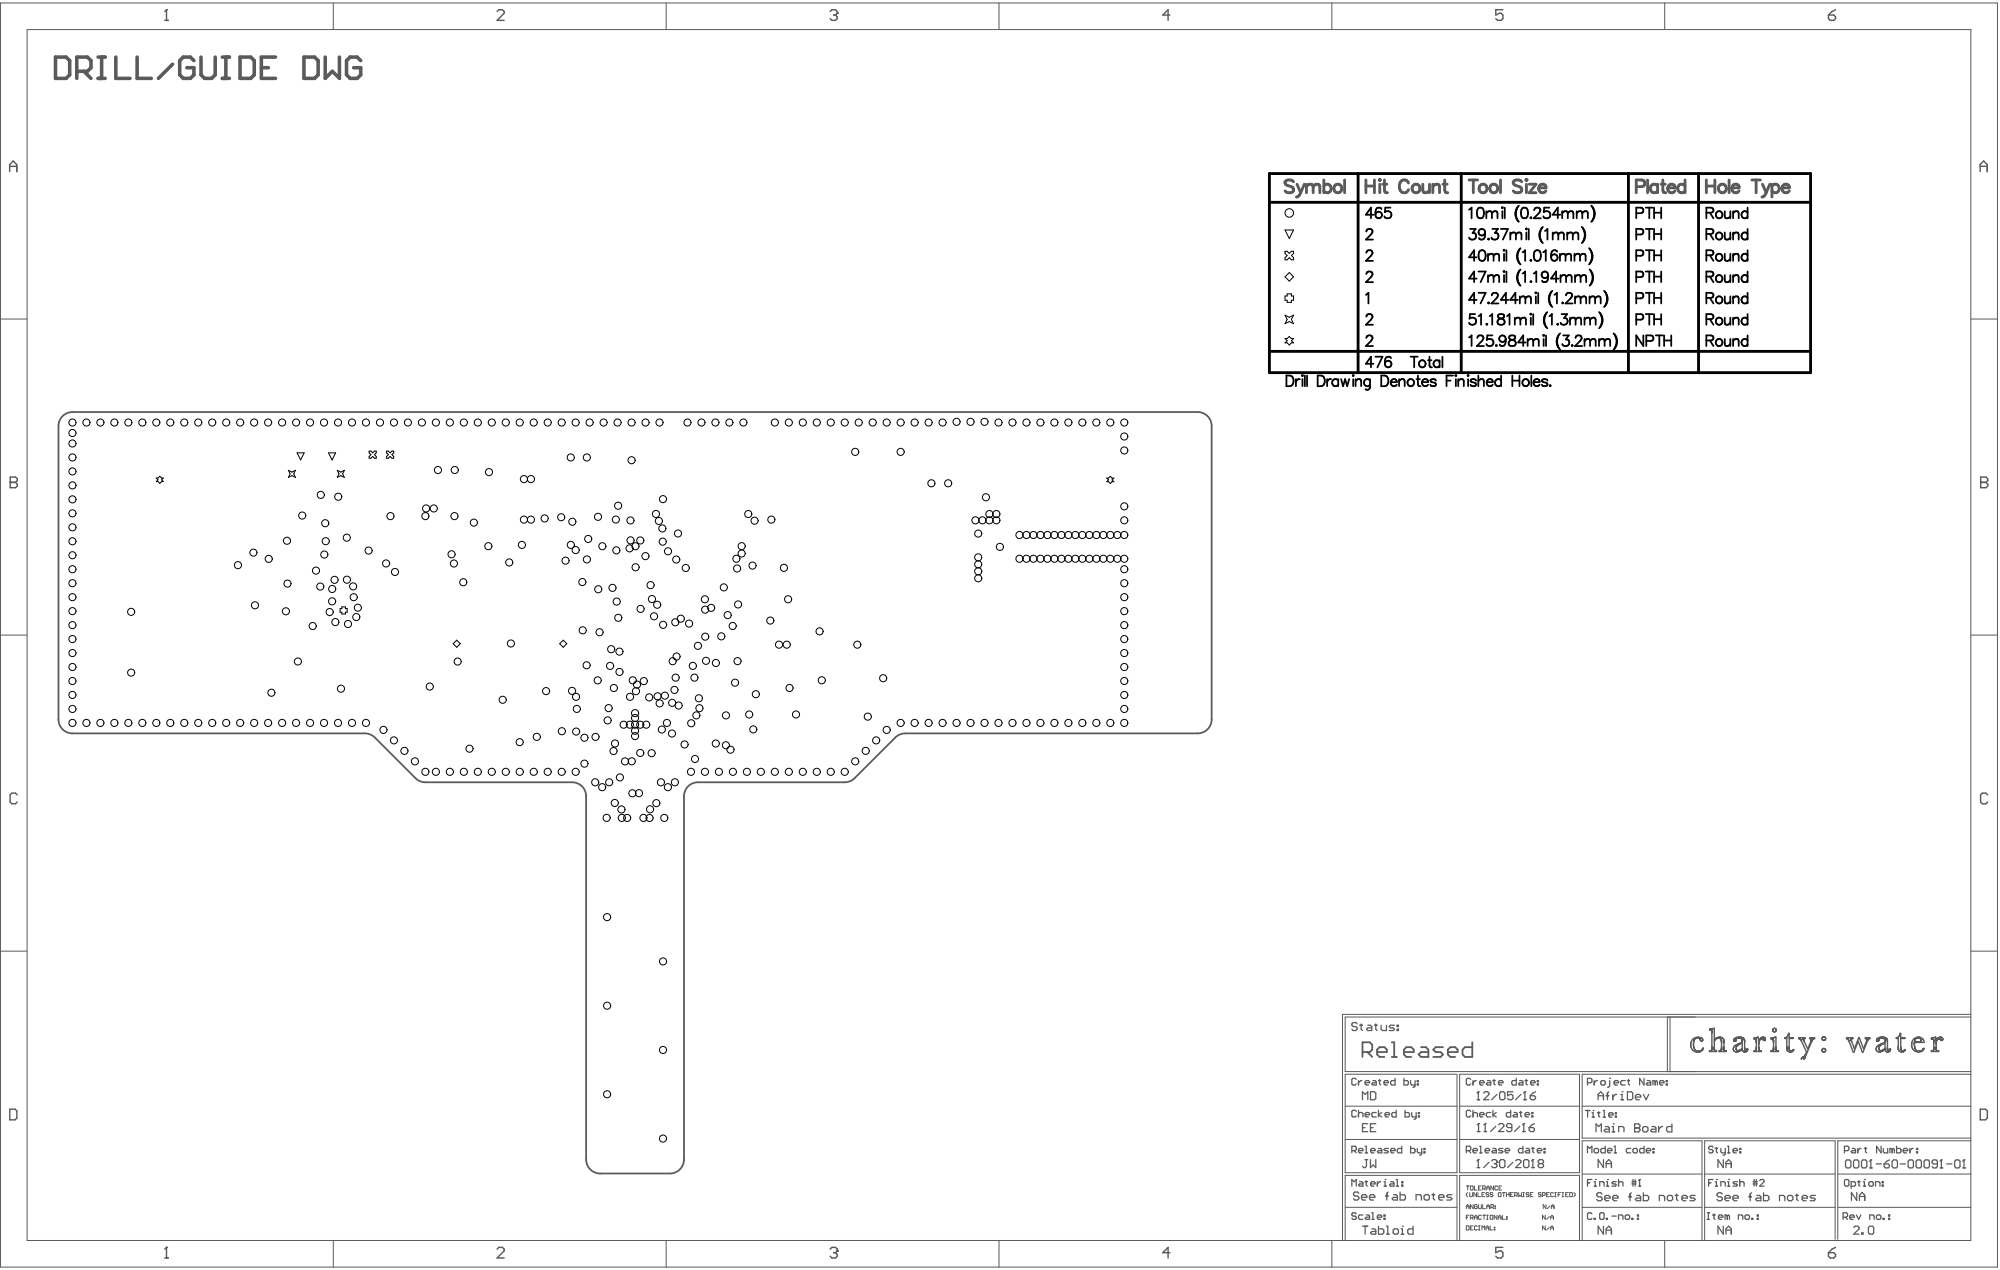
[picture p117: page 1]

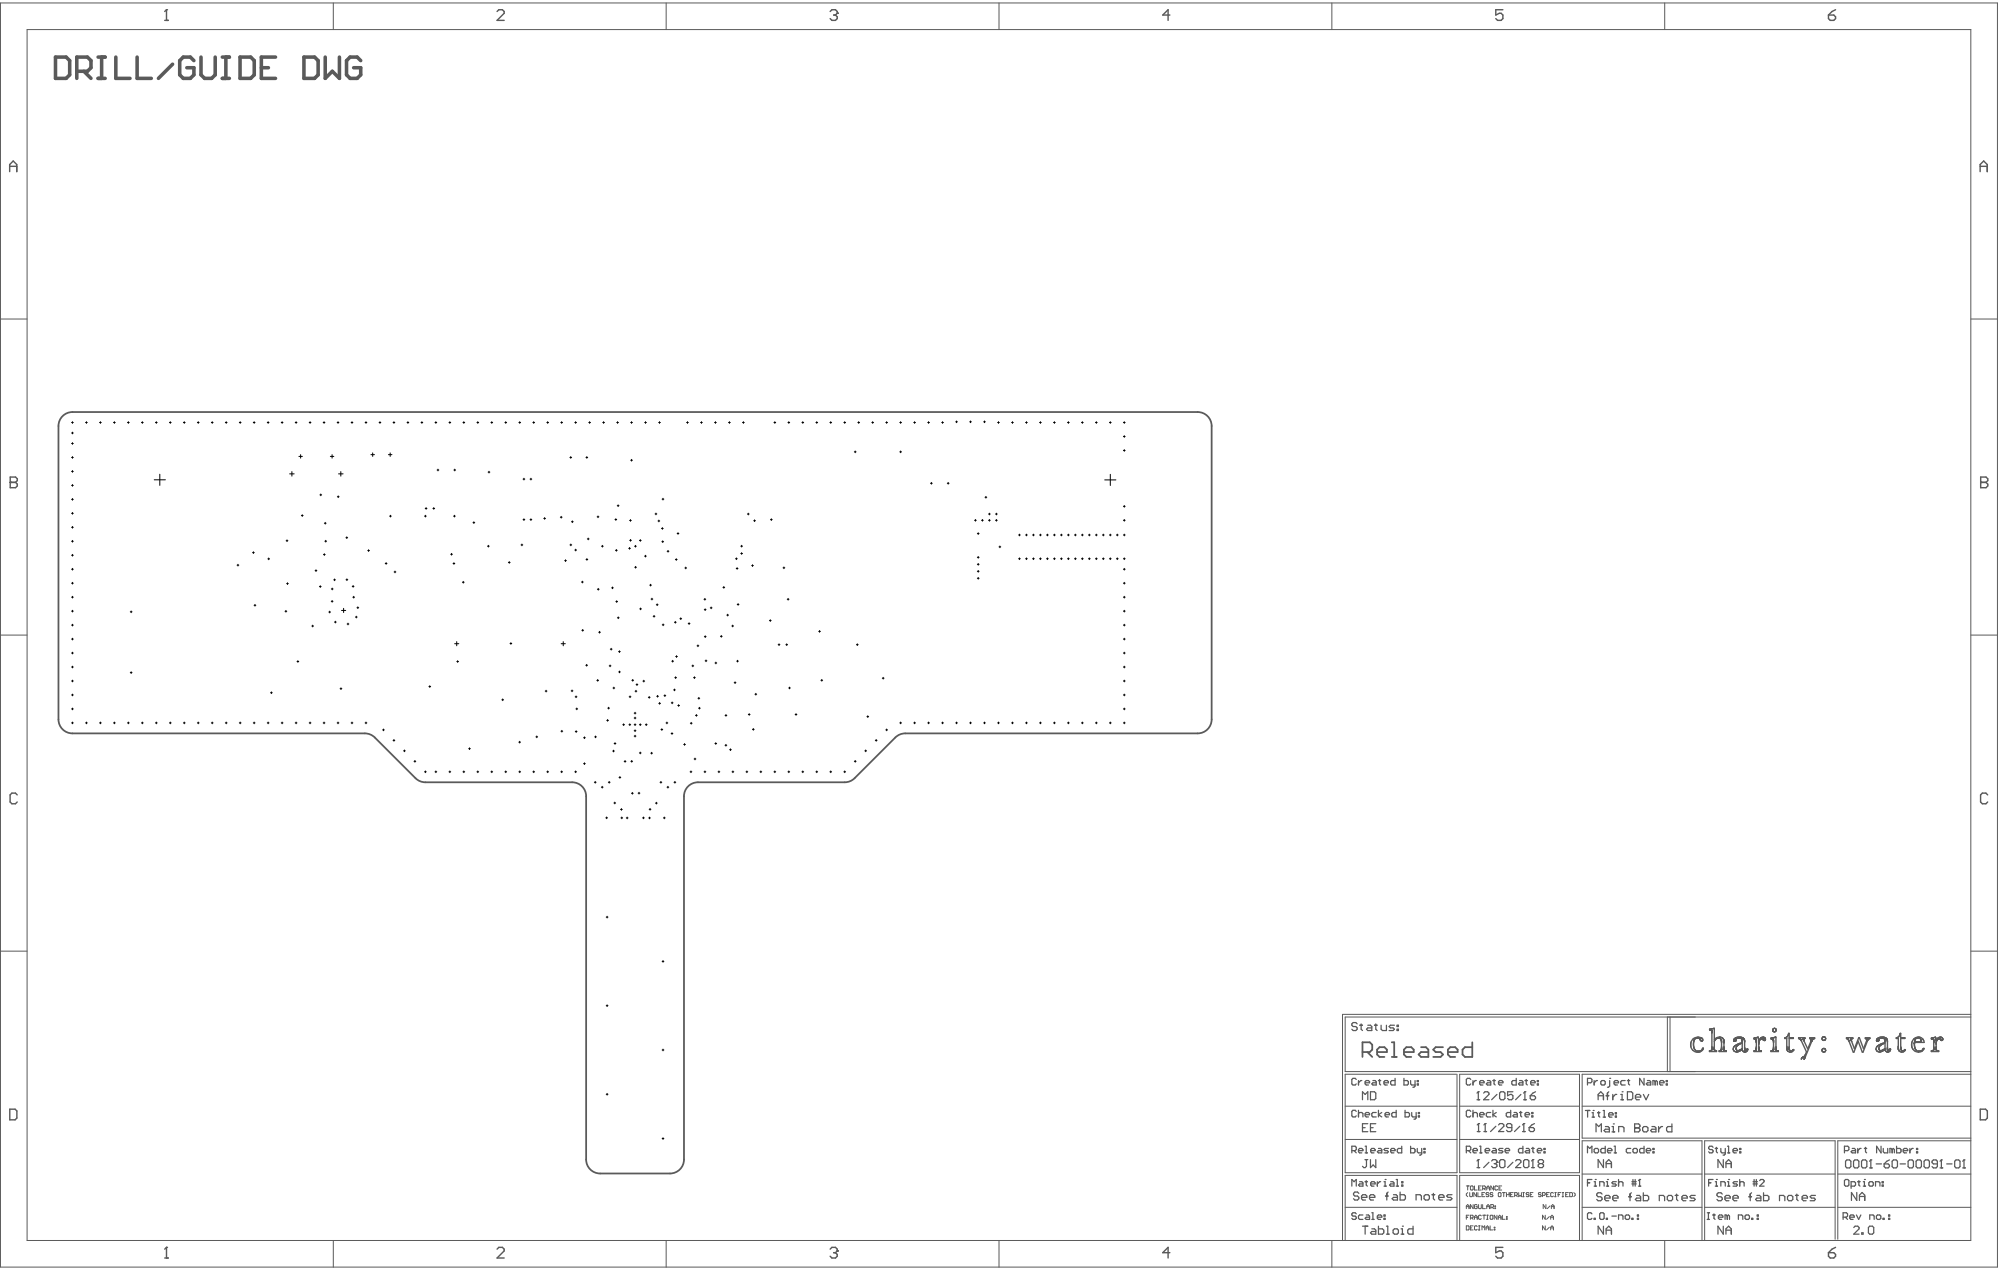
[picture p118: page 2]
