charitywater/afridev2-sensor/software/firmware/application/src/msgScheduler.c

/** 
 * @file msgScheduler.c
 * \n Source File
 * \n Outpour MSP430 Firmware
 * 
 * \brief Schedule a message to be sent to the modem. All 
 *        scheduled messages are always transmitted at 1:05AM
 *        (storage clock time). Messages that are scheduled
 *        include:
 *        \li Activated message
 *        \li Daily Water Log message
 *        \li Monthly Check-In message
 *        \li GPS Location message.
 *
 * \brief Schedule a GPS measurement. The GPS measurement is 
 *        always performed at 12:30AM (if scheduled).
 *  
 * \note There are two ways to send a message to the modem: 
 *       immediate and scheduled. To send a message immediately,
 *       usd the dataMsgMgr_sendDataMsg function. To schedule a
 *       message to be transmitted at 1:05AM (storage clock
 *       time), use the scheduler API's. The scheduler kicks off
 *       the message transmission session at 1:05AM if there are
 *       messages scheduled. The scheduler calls the
 *       dataMsgMgr_startSendingScheduled function to kick off
 *       the transmission session.
 *
 * \par   Copyright Notice
 *        Copyright 2021 charity: water
 *
 *        Licensed under the Apache License, Version 2.0 (the "License");
 *        you may not use this file except in compliance with the License.
 *        You may obtain a copy of the License at
 *
 *            http://www.apache.org/licenses/LICENSE-2.0
 *
 *        Unless required by applicable law or agreed to in writing, software
 *        distributed under the License is distributed on an "AS IS" BASIS,
 *        WITHOUT WARRANTIES OR CONDITIONS OF ANY KIND, either express or implied.
 *        See the License for the specific language governing permissions and
 *        limitations under the License.
 *
 */

#include "outpour.h"

/***************************
 * Module Data Definitions
 **************************/

/**
 * \typedef msgSchedData_t 
 * \brief Define a structure to hold data for this module.
 */
typedef struct msgSchedData_s {
    bool msgScheduled;                                     /**< Flag to indicate there is at least one message scheduled */
    bool sendDailyWaterLogs;                               /**< Flag to indicate the daily water log message is scheduled */
    bool sendActivated;                                    /**< Flag to indicate the Activated message is scheduled */
    bool sendMonthlyCheckIn;                               /**< Flag to indicate the Monthly Check-In message is scheduled */
    bool sendGpsLocation;                                  /**< Flag to indicate the GPS Location message is scheduled */
    bool performGpsMeasurement;                            /**< Flag to indicate the a GPS measurement is scheduled */
    bool sendSensorData;                                   /**< Flag to indicate that Sensor Data snapshot is scheduled */
    bool sendTimeData;                                     /**< Flag to indicate that a Timestamp message is scheduled */
    bool sendFinalAssembly;                               /**< Flag to indicate the Final Assembly message is scheduled */
} msgSchedData_t;

/****************************
 * Module Data Declarations
 ***************************/

/**
* \var msgSchedData
* \brief Declare the data msg object.
*/
// static
msgSchedData_t msgSchedData;

/*************************
 * Module Prototypes
 ************************/

/***************************
 * Module Public Functions
 **************************/

/**
* \brief One time initialization for module.  Call one time 
*        after system starts or (optionally) wakes.
* \ingroup PUBLIC_API
*/
void msgSched_init(void)
{
    // restart with no flags set
    memset(&msgSchedData, 0, sizeof(msgSchedData_t));
}

/**
* \brief Executive that manages this module. Called every 2 
*        seconds from the main processing loop.
* \ingroup EXEC_ROUTINE
*/
void msgSched_exec(void)
{

    // Check if any message is scheduled to be transmitted
    if (msgSchedData.msgScheduled)
    {
        // Get time from the storage module and check against 1:05AM
        if ((storageMgr_getStorageClockHour() == 1) && (storageMgr_getStorageClockMinute() > 4))
        {
            // This should never happen, but check if GPS is active.
            // If it is active, stop it.
            if (gps_isActive())
            {
                gps_stop();
            }
#ifndef WATER_DEBUG
            // Start the transmission cycle
            dataMsgMgr_startSendingScheduled();
#endif
            // Clear flag
            msgSchedData.msgScheduled = false;
        }
    }

#ifndef WATER_DEBUG
    // Check if there a GPS measurement to perform
    if (msgSchedData.performGpsMeasurement)
    {

        // Get time from the storage module and check against 12:30AM
        if ((storageMgr_getStorageClockHour() == 0) && (storageMgr_getStorageClockMinute() > 29))
        {
            // For safety, make sure modem is not active
            // This should never happen, but check just in case.
            if (!modemMgr_isAllocated())
            {
                // Start a GPS measurement
                gps_start();
                msgSchedData.performGpsMeasurement = false;
            }
        }
    }
#endif
}

/**
* \brief Retrieve the next message to transmit (if any). This 
*        function is used by the msgData.c module to retrieve a
*        scheduled message.
* 
* @param cmdWriteP Modem command object that is filled in by 
*                  this function with info on the payload to
*                  send. If the length field is set to zero on
*                  return, it indicates there is no message to
*                  send.
*/
void msgSched_getNextMessageToTransmit(modemCmdWriteData_t *cmdWriteP)
{
    uint8_t *payloadP;
    uint16_t payloadLength = 0;
    MessageType_t payloadMsgId;

    if (msgSchedData.sendFinalAssembly)
    {
        // Retrieve the monthly check-in message payload
        payloadLength = storageMgr_getFinalAssemblyMessage(&payloadP);
        payloadMsgId = MSG_TYPE_FINAL_ASSEMBLY;
        msgSchedData.sendFinalAssembly = false;
    }
    else if (msgSchedData.sendDailyWaterLogs)
    {
        // Start the process of sending the daily logs.
        // Send the oldest daily log that is ready.
        payloadLength = storageMgr_getNextDailyLogToTransmit(&payloadP);
        payloadMsgId = MSG_TYPE_DAILY_LOG;
        if (!payloadLength)
        {
            msgSchedData.sendDailyWaterLogs = false;
        }
    }
    else if (msgSchedData.sendActivated)
    {
        // Retrieve the activated message payload
        payloadLength = storageMgr_getActivatedMessage(&payloadP);
        payloadMsgId = MSG_TYPE_ACTIVATED;
        msgSchedData.sendActivated = false;
    }
    else if (msgSchedData.sendMonthlyCheckIn)
    {
        // Retrieve the monthly check-in message payload
        payloadLength = storageMgr_getMonthlyCheckinMessage(&payloadP);
        payloadMsgId = MSG_TYPE_CHECKIN;
        msgSchedData.sendMonthlyCheckIn = false;
    }
    else if (msgSchedData.sendGpsLocation)
    {
        // Retrieve the monthly GPS message payload
        payloadLength = gps_getGpsMessage(&payloadP);
        payloadMsgId = MSG_TYPE_GPS_LOCATION;
        msgSchedData.sendGpsLocation = false;
    }
#ifdef SEND_DEBUG_TIME_DATA
    else if (msgSchedData.sendTimeData)
    {
        // Retrieve the Water Sense debug data
        payloadLength = storageMgr_getTimestampMessage(&payloadP);
        payloadMsgId = MSG_TYPE_TIMESTAMP;
        msgSchedData.sendTimeData = false;
    }
#endif

    // Initialize the command object
    cmdWriteP->cmd = OUTPOUR_M_COMMAND_SEND_DATA;
    cmdWriteP->payloadMsgId = payloadMsgId;                /* the payload type */
    cmdWriteP->payloadP = payloadP;                        /* the payload pointer */
    cmdWriteP->payloadLength = payloadLength;              /* size of the payload in bytes */
}

/**
* \brief Schedule the daily water logs to be sent when the 
*        Storage clock hour is set to 1:05 AM.
*/
void msgSched_scheduleDailyWaterLogMessage(void)
{
    msgSchedData.msgScheduled = true;
    msgSchedData.sendDailyWaterLogs = true;
}

/**
* \brief Schedule the Activated message to be sent when the 
*        Storage clock hour is set to 1:05 AM.
*/
void msgSched_scheduleActivatedMessage(void)
{
    msgSchedData.msgScheduled = true;
    msgSchedData.sendActivated = true;
}

/**
* \brief Schedule the Monthly Check-In message to be sent when 
*        the Storage clock hour is set to 1:05 AM.
*/
void msgSched_scheduleMonthlyCheckInMessage(void)
{
    msgSchedData.msgScheduled = true;
    msgSchedData.sendMonthlyCheckIn = true;
}

/**
* \brief Schedule the GPS Location message to be sent when the 
*        Storage clock hour is set to 1:05 AM.
*/
void msgSched_scheduleGpsLocationMessage(void)
{
    msgSchedData.msgScheduled = true;
    msgSchedData.sendGpsLocation = true;
}

/**
* \brief Schedule a GPS measurement to be performed when the 
*        Storage clock hour is set to 12:30 AM (i.e. 0 hours, 30
*        minutes).
*/
void msgSched_scheduleGpsMeasurement(void)
{
    msgSchedData.performGpsMeasurement = true;
}

/**
* \brief Schedule the transmission of a snapshot of the
*        water sensing data
*/
void msgSched_scheduleTimeStampMessage(void)
{
    msgSchedData.msgScheduled = true;
    msgSchedData.sendTimeData = true;
}

void msgSched_scheduleFinalAssemblyMessage(void)
{
    msgSchedData.msgScheduled = true;
    msgSchedData.sendFinalAssembly = true;
}
