charitywater/afridev2-sensor/software/firmware/application/src/modemPower.c

/** 
 * @file modemPower.c
 * \n Source File
 * \n Outpour MSP430 Firmware
 * 
 * \brief modem module responsible for bringing up the modem and 
 *        shutting it down.
 *
 * \par   Copyright Notice
 *        Copyright 2021 charity: water
 *
 *        Licensed under the Apache License, Version 2.0 (the "License");
 *        you may not use this file except in compliance with the License.
 *        You may obtain a copy of the License at
 *
 *            http://www.apache.org/licenses/LICENSE-2.0
 *
 *        Unless required by applicable law or agreed to in writing, software
 *        distributed under the License is distributed on an "AS IS" BASIS,
 *        WITHOUT WARRANTIES OR CONDITIONS OF ANY KIND, either express or implied.
 *        See the License for the specific language governing permissions and
 *        limitations under the License.
 *
 */

#include "outpour.h"

/***************************
 * Module Data Definitions
 **************************/

/**
 * \typedef modemPowerOnSeqState_t
 * \brief Define the different states to power on the modem.
 */
typedef enum modemPowerOnSeqState_e {
    MODEM_POWERUP_STATE_IDLE,
    MODEM_POWERUP_STATE_ALL_OFF,
    MODEM_POWERUP_STATE_DCDC,
    MODEM_POWERUP_STATE_LSVCC,
    MODEM_POWERUP_STATE_GSM_HIGH,
    MODEM_POWERUP_STATE_GSM_LOW,
    MODEM_POWERUP_STATE_INIT_WAIT,
    MODEM_POWERUP_STATE_READY,
} modemPowerOnSeqState_t;

/**
 * \typedef modemLinkData_t
 * \brief Module data structure.
 */
typedef struct modemLinkData_s {
    bool active;
    bool modemUp;
    sys_tick_t startTimestamp;
    modemPowerOnSeqState_t powerOnHwSeqState;
} modemLinkData_t;

/****************************
 * Module Data Declarations
 ***************************/

/**
 * \var mlData
 * \brief Declare the object that contains the module data.
 */
// static
modemLinkData_t mlData;

/********************* 
 * Module Prototypes
 *********************/

static void modemPowerUpStateMachine(void);

/***************************
 * Module Public Functions
 **************************/

/**
* \brief Executive that manages sequencing the modem power up 
*        and power down.  Called on the 2 second tick rate to
*        handle bringing the modem up and down.
* \ingroup EXEC_ROUTINE
*/
void modemPower_exec(void)
{
    if (mlData.active)
    {
        modemPowerUpStateMachine();
    }
}

/**
* \brief One time initialization for module.  Call one time 
*        after system starts or (optionally) wakes.
* \ingroup PUBLIC_API
*/
void modemPower_init(void)
{
    memset(&mlData, 0, sizeof(modemLinkData_t));
}

/**
* \brief Start the modem power up sequence.  Will reset the 
*        state machine that manages the power up steps.
* \ingroup PUBLIC_API
*/
void modemPower_restart(void)
{
    mlData.active = true;
    mlData.modemUp = false;
    mlData.powerOnHwSeqState = MODEM_POWERUP_STATE_ALL_OFF;
    mlData.startTimestamp = GET_SYSTEM_TICK();
    modemPowerUpStateMachine();
}

void modemPower_powerDownModem(void)
{
    mlData.active = false;
    mlData.modemUp = false;
    mlData.powerOnHwSeqState = MODEM_POWERUP_STATE_IDLE;
    P1OUT &= ~GSM_DCDC;
    P2OUT &= ~LS_VCC;
}

bool modemPower_isModemOn(void)
{
    return (mlData.modemUp);
}

uint16_t modemPower_getModemOnTimeInSecs(void)
{
    sys_tick_t onTime = GET_ELAPSED_TIME_IN_SEC(mlData.startTimestamp);
    uint16_t onTime16 = onTime;

    return (onTime16);
}

/*************************
 * Module Private Functions
 ************************/

/**
* \brief State machine to sequence through the modem power on 
*        hardware steps. This is a timebased sequence to control
*        the hardware power on.
*/
static void modemPowerUpStateMachine(void)
{
    volatile sys_tick_t onTime = GET_ELAPSED_TIME_IN_SEC(mlData.startTimestamp);

    switch (mlData.powerOnHwSeqState)
    {
        case MODEM_POWERUP_STATE_IDLE:
            break;
        case MODEM_POWERUP_STATE_ALL_OFF:
            P1OUT &= ~GSM_DCDC;
            P2OUT &= ~LS_VCC;
            mlData.powerOnHwSeqState = MODEM_POWERUP_STATE_DCDC;
            break;
        case MODEM_POWERUP_STATE_DCDC:
            if (onTime >= (2 * TIME_SCALER))
            {
                P1OUT |= GSM_DCDC;
                mlData.powerOnHwSeqState = MODEM_POWERUP_STATE_LSVCC;
            }
            break;
        case MODEM_POWERUP_STATE_LSVCC:
            if (onTime >= (4 * TIME_SCALER))
            {
                P2OUT |= LS_VCC;
                mlData.powerOnHwSeqState = MODEM_POWERUP_STATE_GSM_HIGH;
            }
            break;
        case MODEM_POWERUP_STATE_GSM_HIGH:
            if (onTime >= (6 * TIME_SCALER))
            {
                P2OUT |= GSM_EN;
                mlData.powerOnHwSeqState = MODEM_POWERUP_STATE_GSM_LOW;
            }
            break;
        case MODEM_POWERUP_STATE_GSM_LOW:
            if (onTime >= (10 * TIME_SCALER))
            {
                P2OUT &= ~GSM_EN;
                mlData.powerOnHwSeqState = MODEM_POWERUP_STATE_INIT_WAIT;
            }
            break;
        case MODEM_POWERUP_STATE_INIT_WAIT:
            if (onTime >= (15 * TIME_SCALER))
            {
                MODEM_UART_SELECT_ENABLE();
                mlData.powerOnHwSeqState = MODEM_POWERUP_STATE_READY;
                mlData.modemUp = true;
            }
            break;
        case MODEM_POWERUP_STATE_READY:
            break;
    }
}
