charitywater/afridev2-sensor/(commit log)

2019-01-26 Afridev2 ME and EE drawings and files
    [01_hsg_bottom.SLDDRW, 01_hsg_bottom.SLDPRT, 01_hsg_top.SLDDRW, 01_large_oring.SLDPRT, 01_nutplate_internal.SLDDRW, 01_nutplate_internal.SLDPRT, 01_small_oring.SLDPRT, 90116A155.SLDPRT]
2019-02-04 V2.6 Release; resolves Battery Plug-In issue where an error check in the Boot Loader was too strict and SOS mode was entered too easily. Added LED status indicators for Boot Loader error states.
    [main.c, outpour.h]
2019-02-07 Release 2.7; Fixed a bug in Boot Loader where the Oscillator Settings were being made before a 2 mSec "quiet period" specified by TI. The new code waits 25 mSec before setting up the processor's Osci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
    [main.c, outpour.h]
2019-06-04 Added Sensor Data OTA requests to the CWTest15 application
2019-07-03 adding v3.1 firmware changes; low power operation sleep current improvements; updated ADC code to shut down peripheral after each read of PAD temperatures
2019-07-15 Ver 3.2: Release Candidate 2; Contains Low Power Mode Changes, Removed Low Frequency Cap Sense Mode added originally by previous contractor, This is no longer needed with Low Power Mode.
    [hal.c, manufStore.c, outpour.h, sysExec.c, waterSense.c]
2019-07-24 v3.3 release; changed default "water stuck" detection from 30 minutes to 12 hours
    [outpour.h, waterDetect.h, waterSense.c]
2019-08-29 updated message decoder tool to handle 2 byte extension of SensorData message to include trickle volume measurement
2019-08-30 v3.7; added code to detect standing water in the well and prevent this water from being reported as flowing water.
    [outpour.h, sysExec.c, waterSense.c]
2019-09-05 updated message decoder tool to build csv string for analyzing SensorData messages from bodytrace server
2019-09-13 v3.8; increased time after pumping session to adjust air target from 4 seconds to 8. added 1 second RTC time every 5 20 second sleeps to adjust for 1% error. verbose logging disabled
    [debugUart.c, debugUart.h, outpour.h, sysExec.c, waterSense.c, waterSense.h]
2019-09-22 v3.9 added debug messages to view RTC time every minute and at wake time. Added NOP option 8 to Sensor Request message
2019-12-14 v3.17; set water stuck limit to 5 minutes; make water detection resets silent
    [outpour.h, sysExec.c, waterDetect.h]
2019-12-20 v3.18; Fixed a bug where the storage clock was advanced an hour before the previous hour’s water data was recorded.
    [outpour.h, storage.c]
2020-06-04 v4.0 production release; updated v3.28 to send water reports weekly to increase battery life
